GingaShift/hydra-electronics/Elec_Hydra/Main_Board/HYDRA_MAIN_BOARD_V1_A1/HYDRA_MAIN_V1/fabrication/DRILL_REPORT.txt

Drill report for HYDRA_MAIN_V1.kicad_pcb
Created on 2026-10-28T00:51:30+0100

Copper Layer Stackup:
    =============================================================
    L1 :  F.Cu                      front
    L2 :  In1.Cu                    in1
    L3 :  In2.Cu                    in2
    L4 :  B.Cu                      back

Drill file 'HYDRA_MAIN_V1-PTH.drl' contains
    plated through holes:
    =============================================================
    T1  0.300mm  0.0118"  (118 holes)
    T2  0.600mm  0.0236"  (4 holes)  (with 4 slots)
    T3  0.800mm  0.0315"  (17 holes)
    T4  1.000mm  0.0394"  (10 holes)

    Total plated holes count 149

Drill file 'HYDRA_MAIN_V1-NPTH.drl' contains
    unplated through holes:
    =============================================================
    T1  0.650mm  0.0256"  (2 holes)
    T2  2.410mm  0.0949"  (2 holes)
    T3  2.700mm  0.1063"  (4 holes)

    Total unplated holes count 8
