GingaShift/hydra-electronics/Elec_Hydra/Main_Board/HYDRA_MAIN_BOARD_V1_A1/HYDRA_MAIN_V1/docs/OPTIMISATION_A1.md

# Révision A1 — placement compact

|Critère|A0|A1|
|---|---:|---:|
|Largeur|90mm|75mm|
|Hauteur|75mm|60mm|
|Surface|6750mm²|4500mm²|
|Écart de surface|—|−33,3%|

Les87éléments du modèle, les références fabricant, les empreintes et les affectations électriques ont été comparés : aucune modification électrique. Le placement, les pistes, les vias, les contours et les points de fixation sont reconstruits. Le logo vectoriel de40mm est conservé pour respecter ses détails imprimables.

Les composants restent sur la face supérieure. Les plans internes restent dédiés àGND et3V3. Le couloir USB est raccourci par le rapprochement du bord droit et du connecteur. Les dégagements mécaniques et électriques ne sont pas réduits pour masquer un chevauchement.

Les espaces restants servent au branchement, aux fixations, au débogage, à la dissipation et à la sérigraphie; ils ne constituent pas une preuve d’un minimum mathématique de surface. Le contour reste provisoire en attente des contraintes du caisson.

Longueur totale des pistes mesurée dans les fichiers natifs : A0≈1675,5mm, A1≈1516,7mm, soit environ9,5%de moins (somme des segments, hors longueurs verticales des vias).
