GingaShift/hydra-electronics/Elec_Hydra/Main_Board/HYDRA_MAIN_BOARD_V1_A1/HYDRA_MAIN_V1/docs/BOM_DETAIL.csv

Designator | Value | Manufacturer | MPN | Footprint | Notes
U1 | STM32F405RGT6 | STMicroelectronics | STM32F405RGT6 | HYDRA:LQFP-64_10x10mm_P0.5mm
C1 | 100n | Murata | GRM188R71C104KA01D | HYDRA:C_0603_1608Metric
C2 | 100n | Murata | GRM188R71C104KA01D | HYDRA:C_0603_1608Metric
C3 | 100n | Murata | GRM188R71C104KA01D | HYDRA:C_0603_1608Metric
C4 | 100n | Murata | GRM188R71C104KA01D | HYDRA:C_0603_1608Metric
C5 | 4.7u | Murata | GRM21BR71A475KA73L | HYDRA:C_0805_2012Metric
C6 | 2.2u | Murata | GRM188R71A225KE15D | HYDRA:C_0603_1608Metric
C7 | 2.2u | Murata | GRM188R71A225KE15D | HYDRA:C_0603_1608Metric
FB1 | 600R@100MHz | Murata | BLM18AG601SN1D | HYDRA:L_0603_1608Metric
C8 | 100n | Murata | GRM188R71C104KA01D | HYDRA:C_0603_1608Metric
C9 | 4.7u | Murata | GRM21BR71A475KA73L | HYDRA:C_0805_2012Metric
Y1 | 8MHz CL10pF | ECS | ECS-80-10-33-CHN-TR | HYDRA:Crystal_SMD_3225-4Pin_3.2x2.5mm | CL10pF; C0max5pF ESRmax400R; gmcrit0.91mA/V, qualifier oscillation
C10 | 14p | Murata | GRM1885C1H140JA01D | HYDRA:C_0603_1608Metric
C11 | 14p | Murata | GRM1885C1H140JA01D | HYDRA:C_0603_1608Metric
R1 | 10k | Yageo | RC0603FR-0710KL | HYDRA:R_0603_1608Metric
R2 | 10k | Yageo | RC0603FR-0710KL | HYDRA:R_0603_1608Metric
R3 | 10k | Yageo | RC0603FR-0710KL | HYDRA:R_0603_1608Metric
C12 | 100n | Murata | GRM188R71C104KA01D | HYDRA:C_0603_1608Metric
SW1 | BOOT | E-Switch | TL3342F160QG | HYDRA:SW_SPST_TL3342
SW2 | RESET | E-Switch | TL3342F160QG | HYDRA:SW_SPST_TL3342
J1 | 5V POWER IN | Molex | 43650-0221 | HYDRA:Molex_Micro-Fit_3.0_43650-0221_1x02_P3.00mm_Vertical
F1 | 0.50A hold | Littelfuse | 1206L050/15YR | HYDRA:Fuse_1206_3216Metric
F2 | 0.50A hold | Littelfuse | 1206L050/15YR | HYDRA:Fuse_1206_3216Metric
D1 | SS14 | Vishay | SS14-E3/61T | HYDRA:D_SMA | OR passif; protege retours et inversion polarite
D2 | SS14 | Vishay | SS14-E3/61T | HYDRA:D_SMA | OR passif; protege retours et inversion polarite
U2 | AP7361C-33E-13 | Diodes Inc. | AP7361C-33E-13 | HYDRA:SOT-223-3_TabPin2 | SOT223: 1IN 2GND/tab 3OUT, pas AMS1117
C13 | 4.7u | Murata | GRM21BR71A475KA73L | HYDRA:C_0805_2012Metric
C14 | 4.7u | Murata | GRM21BR71A475KA73L | HYDRA:C_0805_2012Metric
C15 | 100n | Murata | GRM188R71C104KA01D | HYDRA:C_0603_1608Metric
J5 | USB-C USB2 DEVICE | GCT | USB4105-GF-A | HYDRA:USB_C_Receptacle_GCT_USB4105-xx-A_16P_TopMnt_Horizontal
R4 | 5.1k | Yageo | RC0603FR-075K1L | HYDRA:R_0603_1608Metric
R5 | 5.1k | Yageo | RC0603FR-075K1L | HYDRA:R_0603_1608Metric
U5 | USBLC6-2SC6 | STMicroelectronics | USBLC6-2SC6 | HYDRA:SOT-23-6
C16 | 100n | Murata | GRM188R71C104KA01D | HYDRA:C_0603_1608Metric
R6 | 22 | Yageo | RC0603FR-0722RL | HYDRA:R_0603_1608Metric
R7 | 22 | Yageo | RC0603FR-0722RL | HYDRA:R_0603_1608Metric
R8 | 33k | Yageo | RC0603FR-0733KL | HYDRA:R_0603_1608Metric
R9 | 82k | Yageo | RC0603FR-0782KL | HYDRA:R_0603_1608Metric
R10 | 3.3k | Yageo | RC0603FR-073K3L | HYDRA:R_0603_1608Metric
D3 | PWR_5V | Lite-On | LTST-C190KGKT | HYDRA:LED_0603_1608Metric | green
R11 | 2.2k | Yageo | RC0603FR-072K2L | HYDRA:R_0603_1608Metric
D4 | PWR_3V3 | Lite-On | LTST-C190KGKT | HYDRA:LED_0603_1608Metric | green
R12 | 1k | Yageo | RC0603FR-071KL | HYDRA:R_0603_1608Metric
D5 | STATUS | Lite-On | LTST-C190TBKT | HYDRA:LED_0603_1608Metric | blue
R13 | 2.2k | Yageo | RC0603FR-072K2L | HYDRA:R_0603_1608Metric
D6 | DATA | Lite-On | LTST-C190KSKT | HYDRA:LED_0603_1608Metric | yellow
U3 | W25Q128JVSIQ | Winbond | W25Q128JVSIQ | HYDRA:SOIC-8_5.23x5.23mm_P1.27mm
C17 | 100n | Murata | GRM188R71C104KA01D | HYDRA:C_0603_1608Metric
C18 | 4.7u | Murata | GRM21BR71A475KA73L | HYDRA:C_0805_2012Metric
R14 | 10k | Yageo | RC0603FR-0710KL | HYDRA:R_0603_1608Metric
R15 | 10k | Yageo | RC0603FR-0710KL | HYDRA:R_0603_1608Metric
R16 | 10k | Yageo | RC0603FR-0710KL | HYDRA:R_0603_1608Metric
U4 | BME280 | Bosch Sensortec | BME280 | HYDRA:Bosch_LGA-8_2.5x2.5mm_P0.65mm_ClockwisePinNumbering | I2C3 adresse7bits0x77, CSB1 SDO1
C19 | 100n | Murata | GRM188R71C104KA01D | HYDRA:C_0603_1608Metric
C20 | 100n | Murata | GRM188R71C104KA01D | HYDRA:C_0603_1608Metric
R17 | 4.7k | Yageo | RC0603FR-074K7L | HYDRA:R_0603_1608Metric
R18 | 4.7k | Yageo | RC0603FR-074K7L | HYDRA:R_0603_1608Metric
R19 | 10k | Yageo | RC0603FR-0710KL | HYDRA:R_0603_1608Metric
J2 | POWER I2C ALERT | Molex | 53253-0470 | HYDRA:Molex_Micro-Latch_53253-0470_1x04_P2.00mm_Vertical
R20 | 47 | Yageo | RC0603FR-0747RL | HYDRA:R_0603_1608Metric
R21 | 47 | Yageo | RC0603FR-0747RL | HYDRA:R_0603_1608Metric
R22 | 1k | Yageo | RC0603FR-071KL | HYDRA:R_0603_1608Metric
R23 | 2.2k | Yageo | RC0603FR-072K2L | HYDRA:R_0603_1608Metric
R24 | 2.2k | Yageo | RC0603FR-072K2L | HYDRA:R_0603_1608Metric
R25 | 10k | Yageo | RC0603FR-0710KL | HYDRA:R_0603_1608Metric
J3 | RPi UART 3V3 | Molex | 53253-0370 | HYDRA:Molex_Micro-Latch_53253-0370_1x03_P2.00mm_Vertical | vers Navigator SERIAL3: 1 vers RX3, 2 vers TX2, 3 vers GND6
R26 | 1k | Yageo | RC0603FR-071KL | HYDRA:R_0603_1608Metric
R27 | 1k | Yageo | RC0603FR-071KL | HYDRA:R_0603_1608Metric
J4 | 8 GPIO V2 LOGIC | Molex | 53253-1070 | HYDRA:Molex_Micro-Latch_53253-1070_1x10_P2.00mm_Vertical | 3V3 logique max50mA; aucune puissance actionneur
J6 | SWD 2.54mm | Wurth | 61301021121 | HYDRA:PinHeader_2x05_P2.54mm_Vertical | Standard ARM signaux mais pas pas1.27: adaptateur requis
TP1 | +5V_SYS |  |  | HYDRA:TestPoint_Pad_D1.5mm | Test pad
TP2 | +3V3 |  |  | HYDRA:TestPoint_Pad_D1.5mm | Test pad
TP3 | GND |  |  | HYDRA:TestPoint_Pad_D1.5mm | Test pad
TP4 | NRST |  |  | HYDRA:TestPoint_Pad_D1.5mm | Test pad
TP5 | UART_TX |  |  | HYDRA:TestPoint_Pad_D1.5mm | Test pad
TP6 | UART_RX |  |  | HYDRA:TestPoint_Pad_D1.5mm | Test pad
TP7 | PB_SDA |  |  | HYDRA:TestPoint_Pad_D1.5mm | Test pad
TP8 | PB_SCL |  |  | HYDRA:TestPoint_Pad_D1.5mm | Test pad
TP9 | INA_ALERT |  |  | HYDRA:TestPoint_Pad_D1.5mm | Test pad
TP10 | BOOT0 |  |  | HYDRA:TestPoint_Pad_D1.5mm | Test pad
H1 | M2.5 NPTH |  |  | HYDRA:MountingHole_2.7mm_M2.5
H2 | M2.5 NPTH |  |  | HYDRA:MountingHole_2.7mm_M2.5
H3 | M2.5 NPTH |  |  | HYDRA:MountingHole_2.7mm_M2.5
H4 | M2.5 NPTH |  |  | HYDRA:MountingHole_2.7mm_M2.5
