GingaShift/hydra-electronics/Elec_Hydra/Main_Board/HYDRA_MAIN_BOARD_V1_A1/HYDRA_MAIN_V1/Importations 3D/ECS-80-10-33-CHN-TR.stp

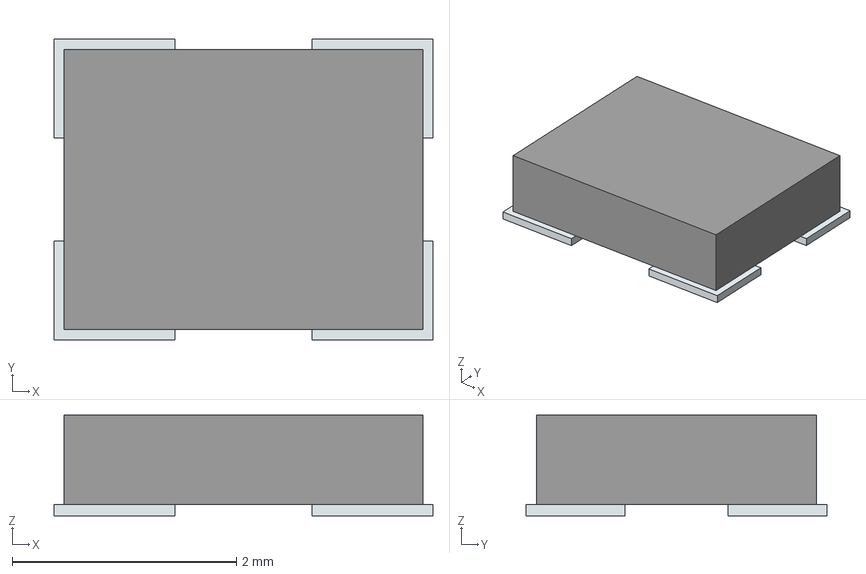
[picture p10: CAD file, 2026-11-01]
Elec_Hydra/Main_Board/HYDRA_MAIN_BOARD_V1_A1/HYDRA_MAIN_V1/Importations 3D/ECS-80-10-33-CHN-TR.stp
3.38 x 2.68 x 0.9 mm
Pins
