GingaShift/hydra-electronics/Elec_Hydra/Main_Board/HYDRA_MAIN_BOARD_V1_A1/HYDRA_MAIN_V1/Importations 3D/TL3342F160QG.stp

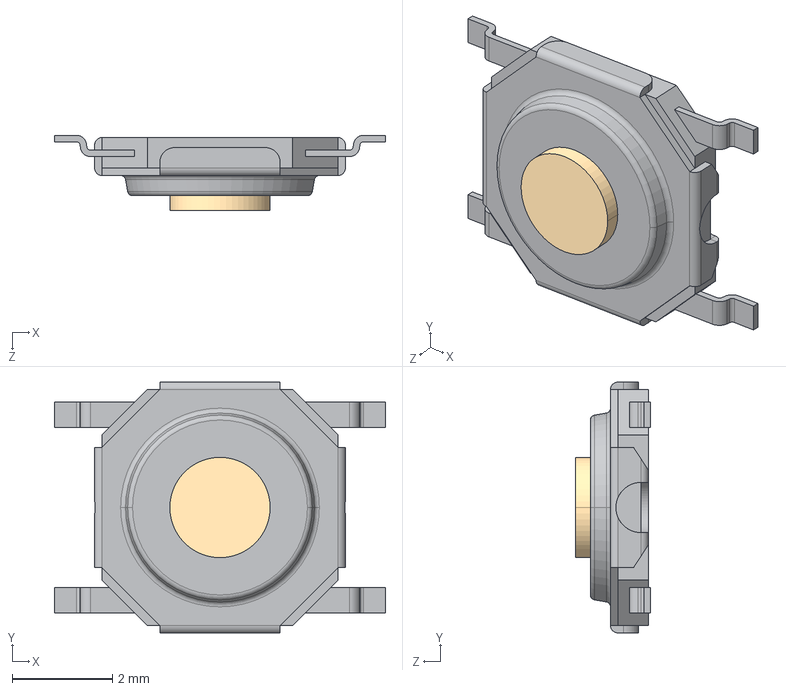
[picture p11: CAD file, 2026-11-01]
Elec_Hydra/Main_Board/HYDRA_MAIN_BOARD_V1_A1/HYDRA_MAIN_V1/Importations 3D/TL3342F160QG.stp
6.60 x 5.00 x 1.50 mm
