GingaShift/hydra-electronics/Elec_Hydra/Main_Board/HYDRA_MAIN_BOARD_V1_A1/HYDRA_MAIN_V1/Importations 3D/0532530370.stp

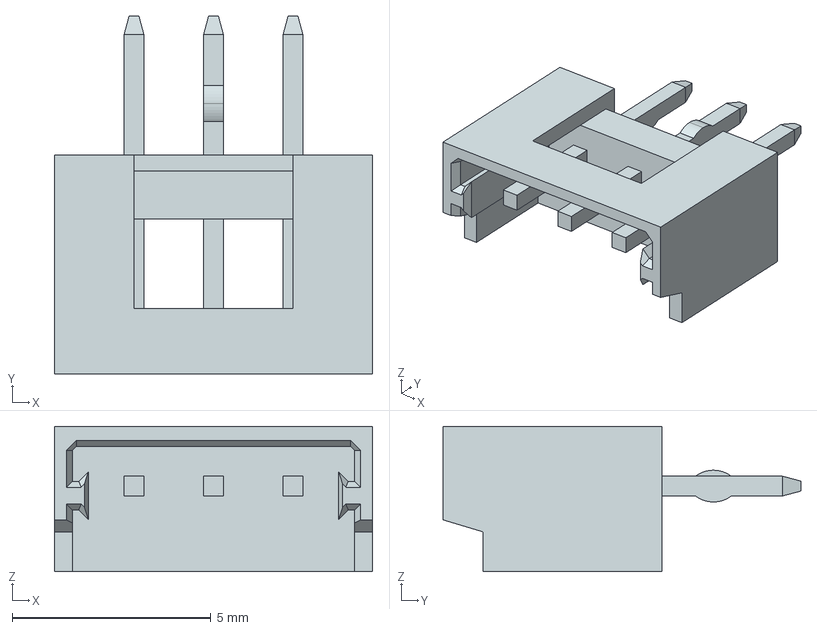
[picture p12: CAD file, 2026-11-01]
Elec_Hydra/Main_Board/HYDRA_MAIN_BOARD_V1_A1/HYDRA_MAIN_V1/Importations 3D/0532530370.stp
8.00 x 9.00 x 3.65 mm
