GingaShift/hydra-electronics/Elec_Hydra/Main_Board/HYDRA_MAIN_BOARD_V1_A1/HYDRA_MAIN_V1/Importations 3D/1206L050_15YR.stp

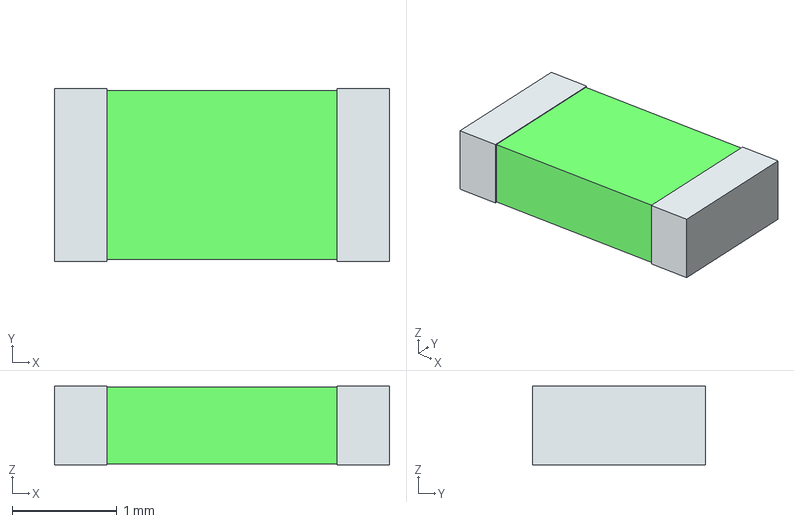
[picture p13: CAD file, 2026-11-01]
Elec_Hydra/Main_Board/HYDRA_MAIN_BOARD_V1_A1/HYDRA_MAIN_V1/Importations 3D/1206L050_15YR.stp
3.20 x 1.65 x 0.75 mm
term1
term2
