GingaShift/hydra-electronics/Elec_Hydra/Main_Board/HYDRA_MAIN_BOARD_V1_A1/HYDRA_MAIN_V1/Importations 3D/0532530470.stp

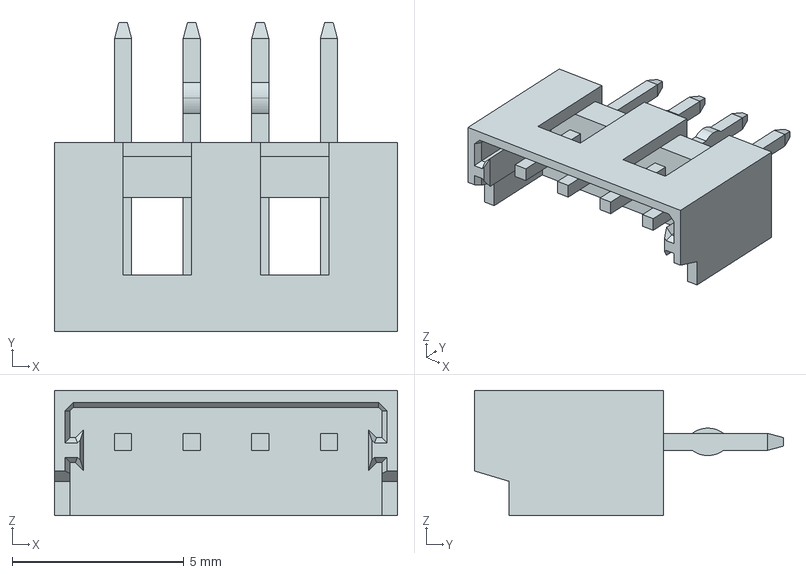
[picture p14: CAD file, 2026-11-01]
Elec_Hydra/Main_Board/HYDRA_MAIN_BOARD_V1_A1/HYDRA_MAIN_V1/Importations 3D/0532530470.stp
10.0 x 9.00 x 3.65 mm
