GingaShift/hydra-electronics/Elec_Hydra/Main_Board/HYDRA_MAIN_BOARD_V1_A1/HYDRA_MAIN_V1/reports/pcb_build.txt

Supply fanouts 83 unplaced []
Board generated 84 footprints 58 nets
U1 19 35.25 35.675
U1 32 41.75 35.675
U1 48 43.675 26.25
U1 64 34.25 24.325
U1 31 41.25 35.675
U1 47 43.675 26.75
U1 44 43.675 28.25
U1 45 43.675 27.75
U1 5 32.325 28.25
U1 6 32.325 28.75
U1 12 32.325 31.75
U1 13 32.325 32.25
