GingaShift/hydra-electronics/Elec_Hydra/Main_Board/HYDRA_MAIN_BOARD_V1_A1/HYDRA_MAIN_V1/reports/VALIDATION.md

# Validation A1 compacte

Contour75×60mm,6750→4500mm² (−33,3%). Les références, empreintes, valeurs et nets des87éléments du modèle ont été comparés àA0 : aucun changement électrique. La sérigraphie, les fixations, le placement et le routage sont reconstruits.

Contrôles natifsKiCad9.0.9 : ERC0, DRC0, connexions non routées0, parité schéma/PCB0. Comparaison indépendante XML schéma/pastilles :0écart. Routage final :675segments,118vias. Deux plans internes remplisGND/In1.Cu et3V3/In2.Cu, aucune piste de signal interne.

La liaison STATUS a été routée avant les autres signaux afin de préserver son accès depuisPC8 dans le placement compact. Les deux LEDs d’alimentation, STATUS/DATA et toutes les extensions sont conservées.

Le logo vectoriel officiel40mm reste inchangé. Le contour mécanique est provisoire. Les réserves de qualification physique, thermique, HSE etUSB, de stackup90Ω, de configurationBlueOS et de stock/assemblage restent celles du dossier technique. Aucun essai matériel n’est revendiqué.

**NO-GO commande automatique** avant validation mécanique et qualification du prototype.
