GingaShift/hydra-electronics/Elec_Hydra/Main_Board/HYDRA_MAIN_BOARD_V1_A1/HYDRA_MAIN_V1/HYDRA_SCHEMA.pdf

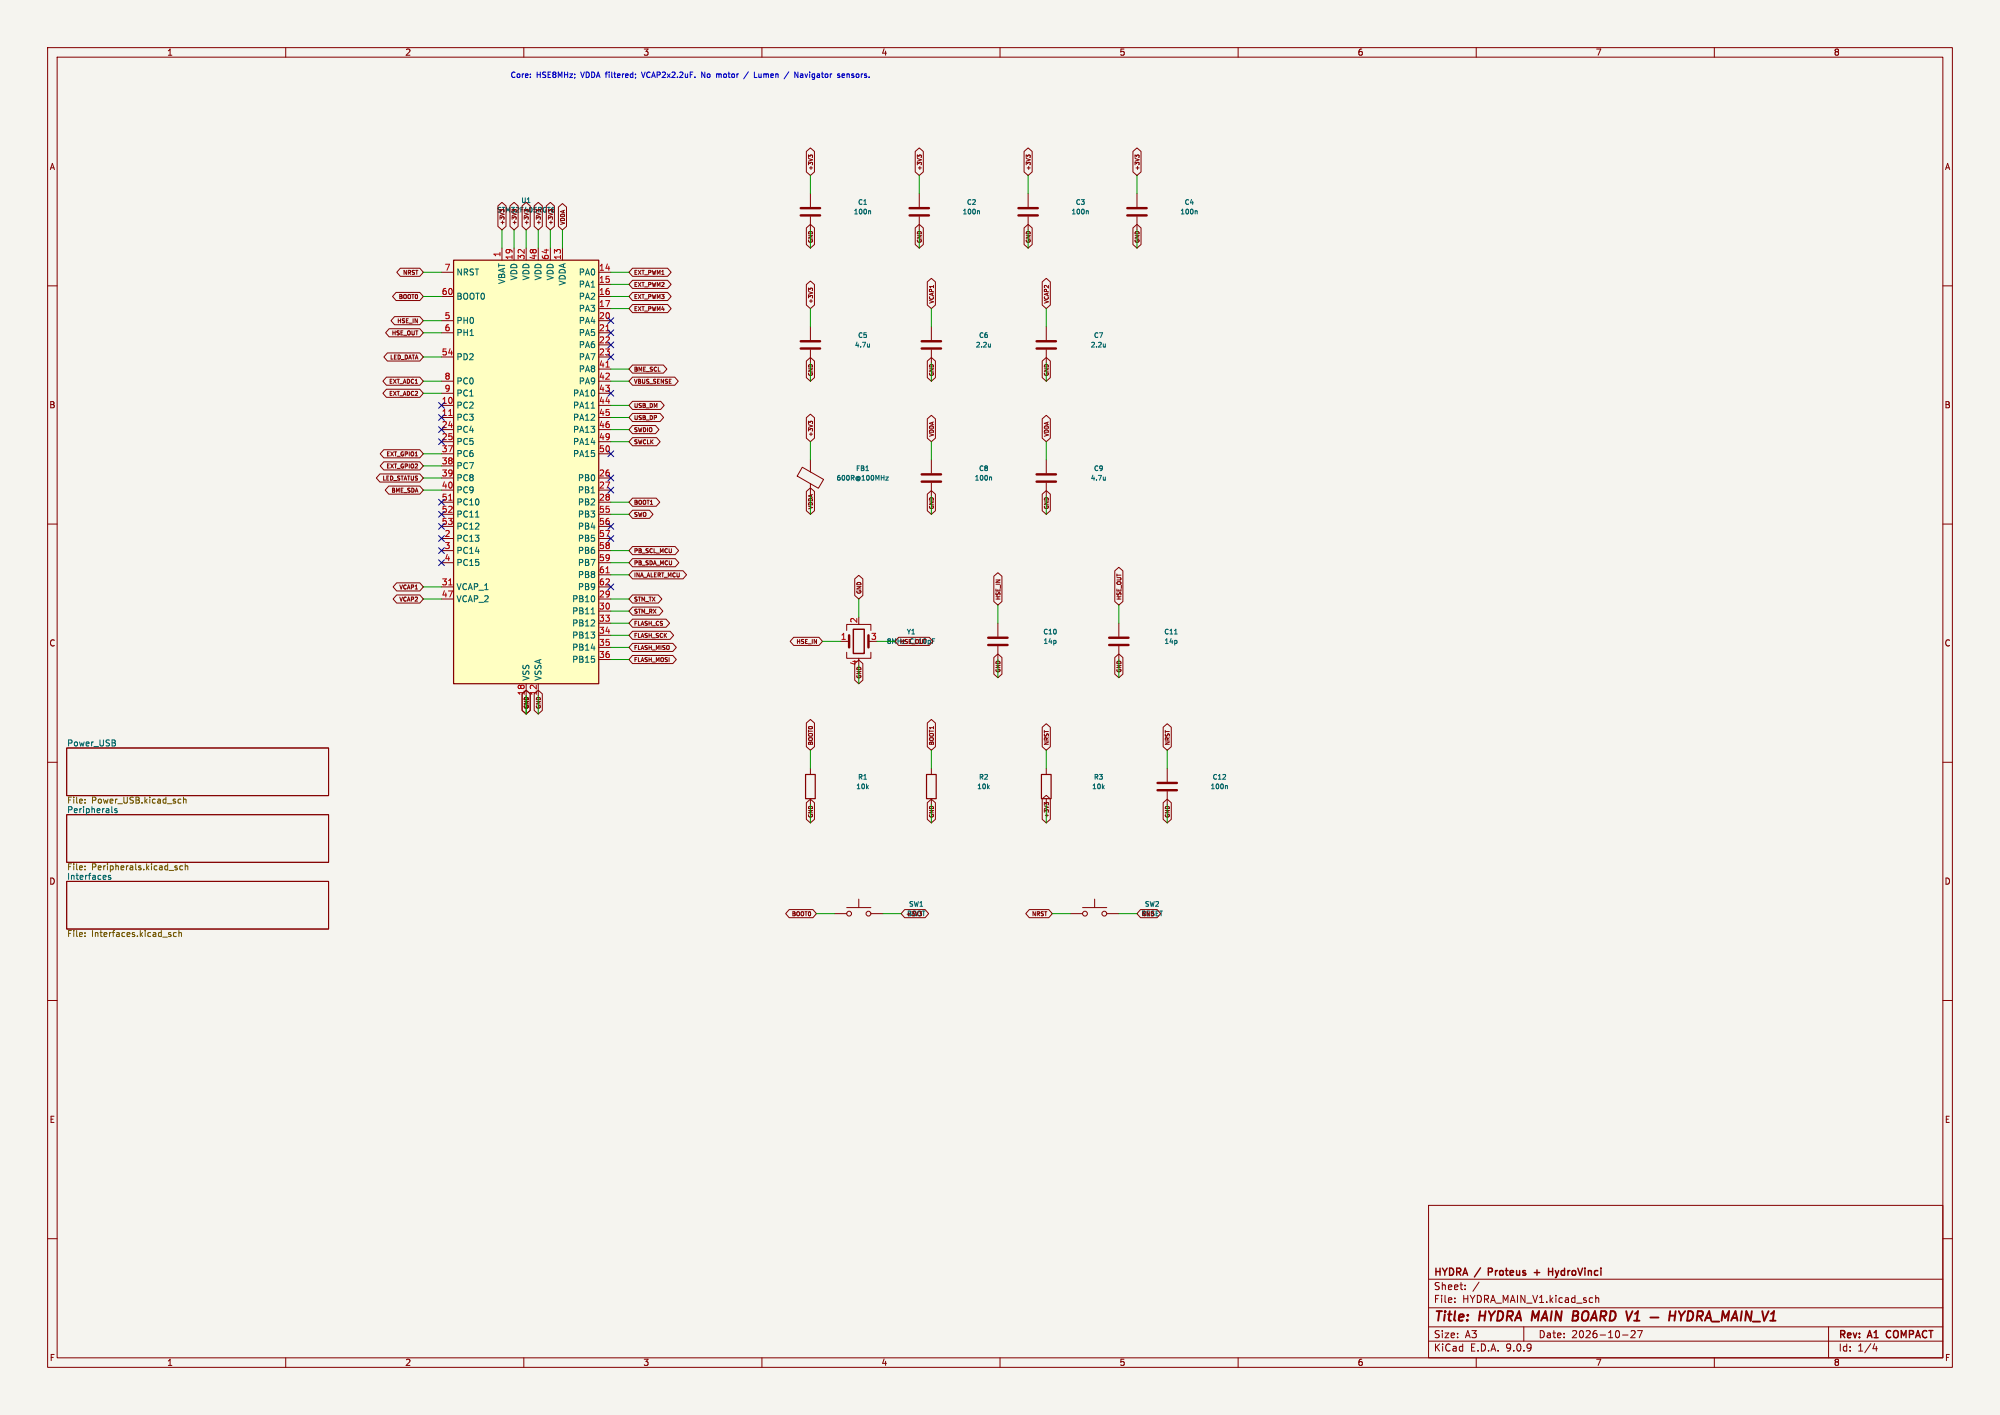
[picture p17: page 1]

1 VDD 19 VDD 32 VSS 18 VDD 48 VSSA 12 VDD 64 VDDA 13 PA0 14 PA1 15 PA2 16 PA3 17 PA4 20 PA5 21 PA6 22 PA7 23 PA8 41 PA9 42 PA10 43 PA11 44 PA12 45 PA13 46 PA14 49 PA15 50 PB0 26 PB1 27 PB2 28 PB3 55 PB4 56 PB5 57 PB6 58 PB7 59 PB8 61 PB9 62 PB10 29 PB11 30 PB12 33 PB13 34 PB14 35 PB15 36

Interfaces File: Interfaces.kicad_sch Peripherals File: Peripherals.kicad_sch Power_USB

Id: 1/4 Title: HYDRA MAIN BOARD V1 þÿ HYDRA_MAIN_V1

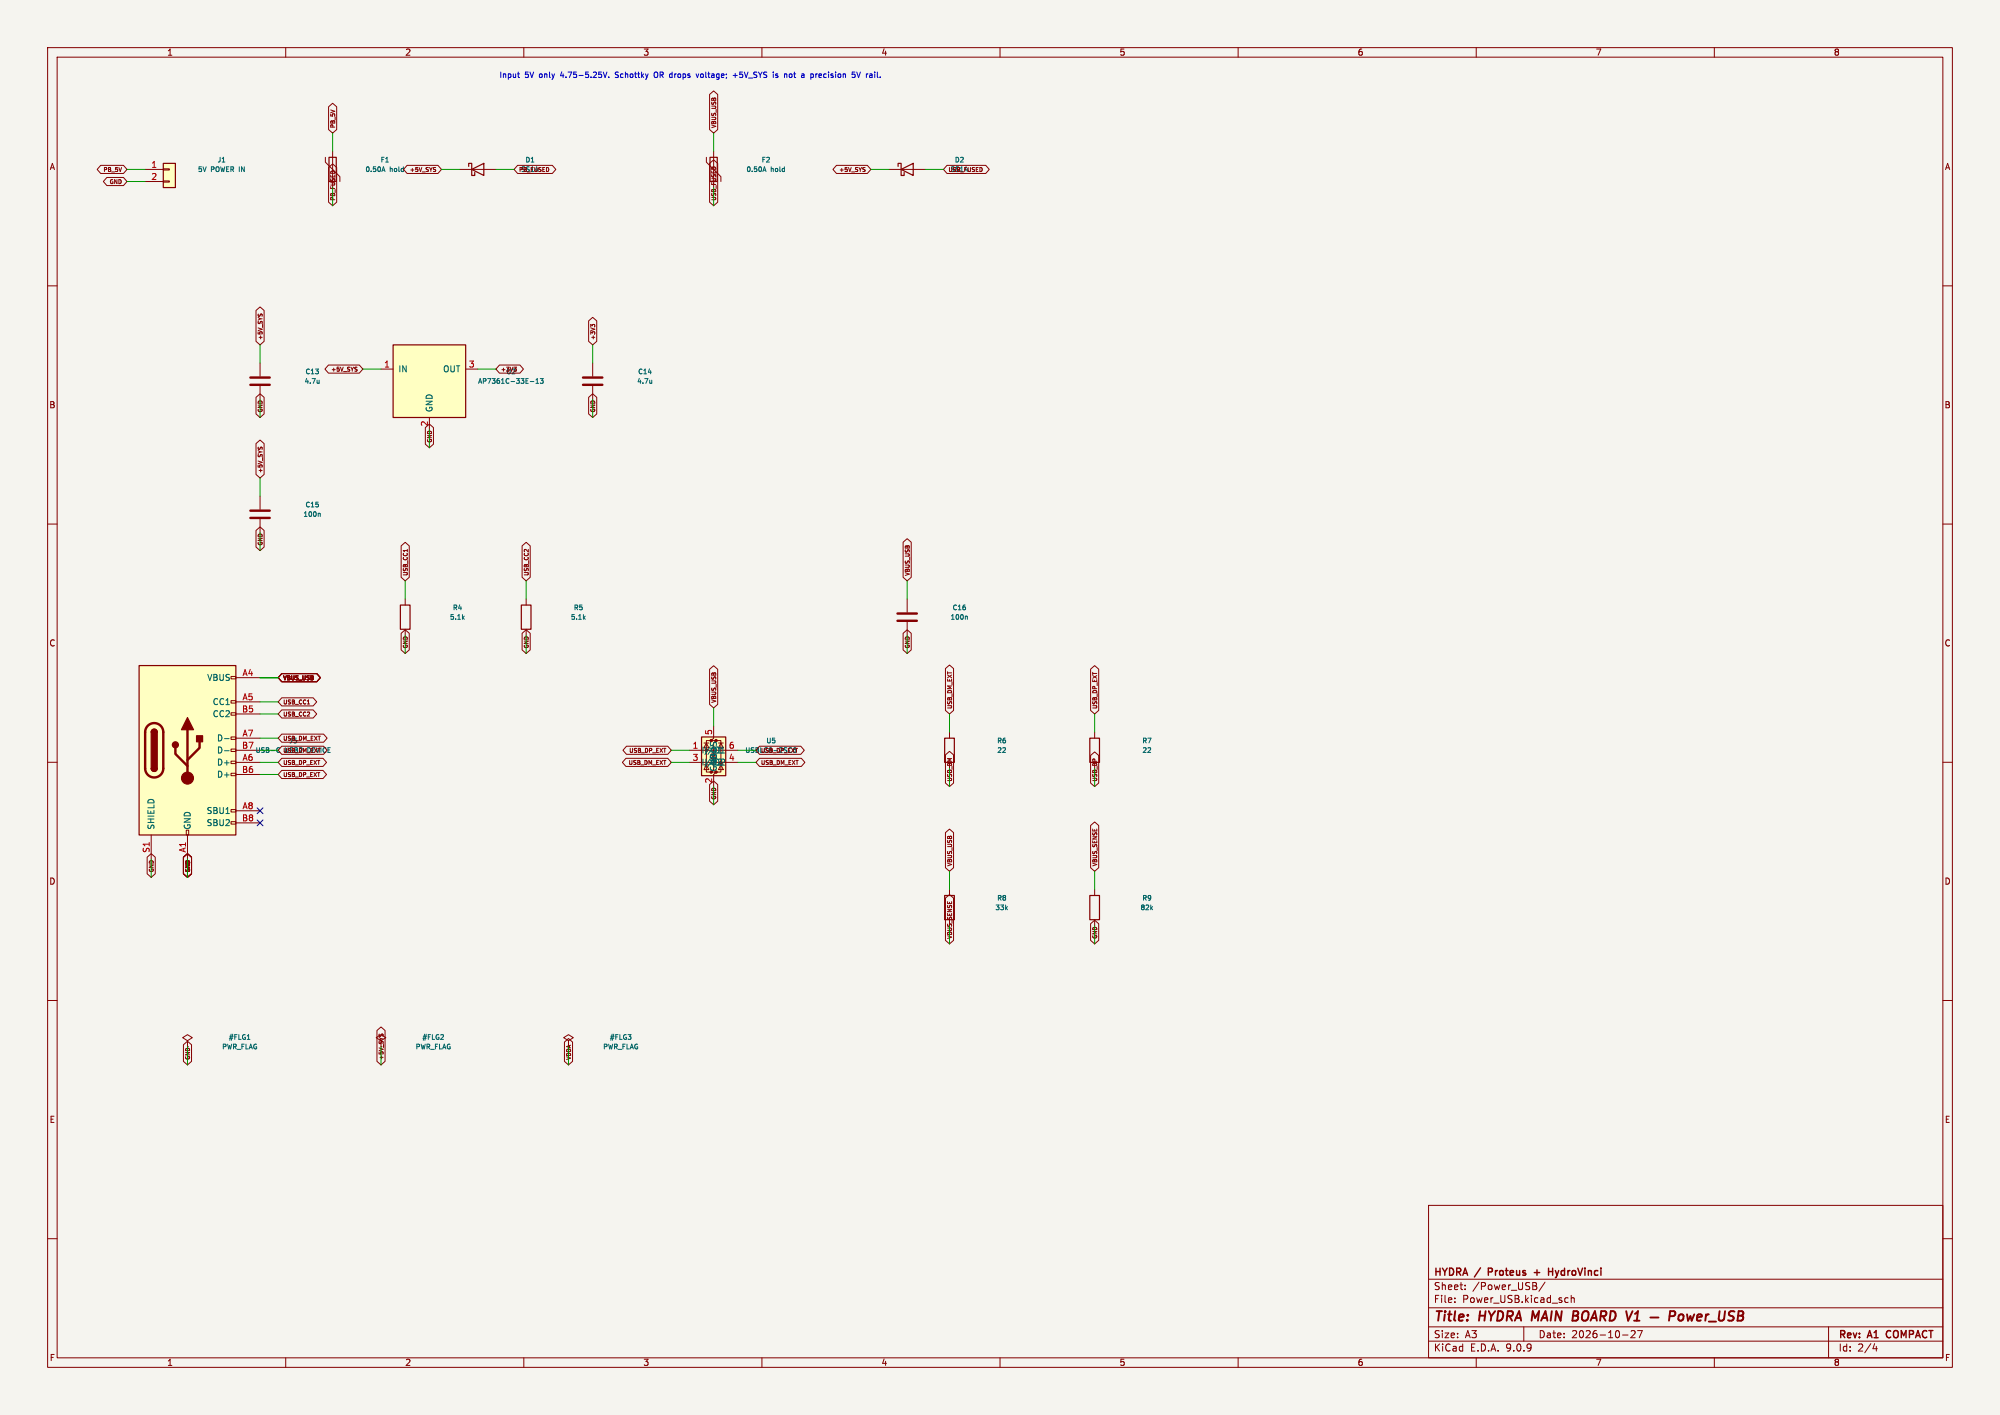
[picture p18: page 2]

Id: 2/4 Title: HYDRA MAIN BOARD V1 þÿ Power_USB

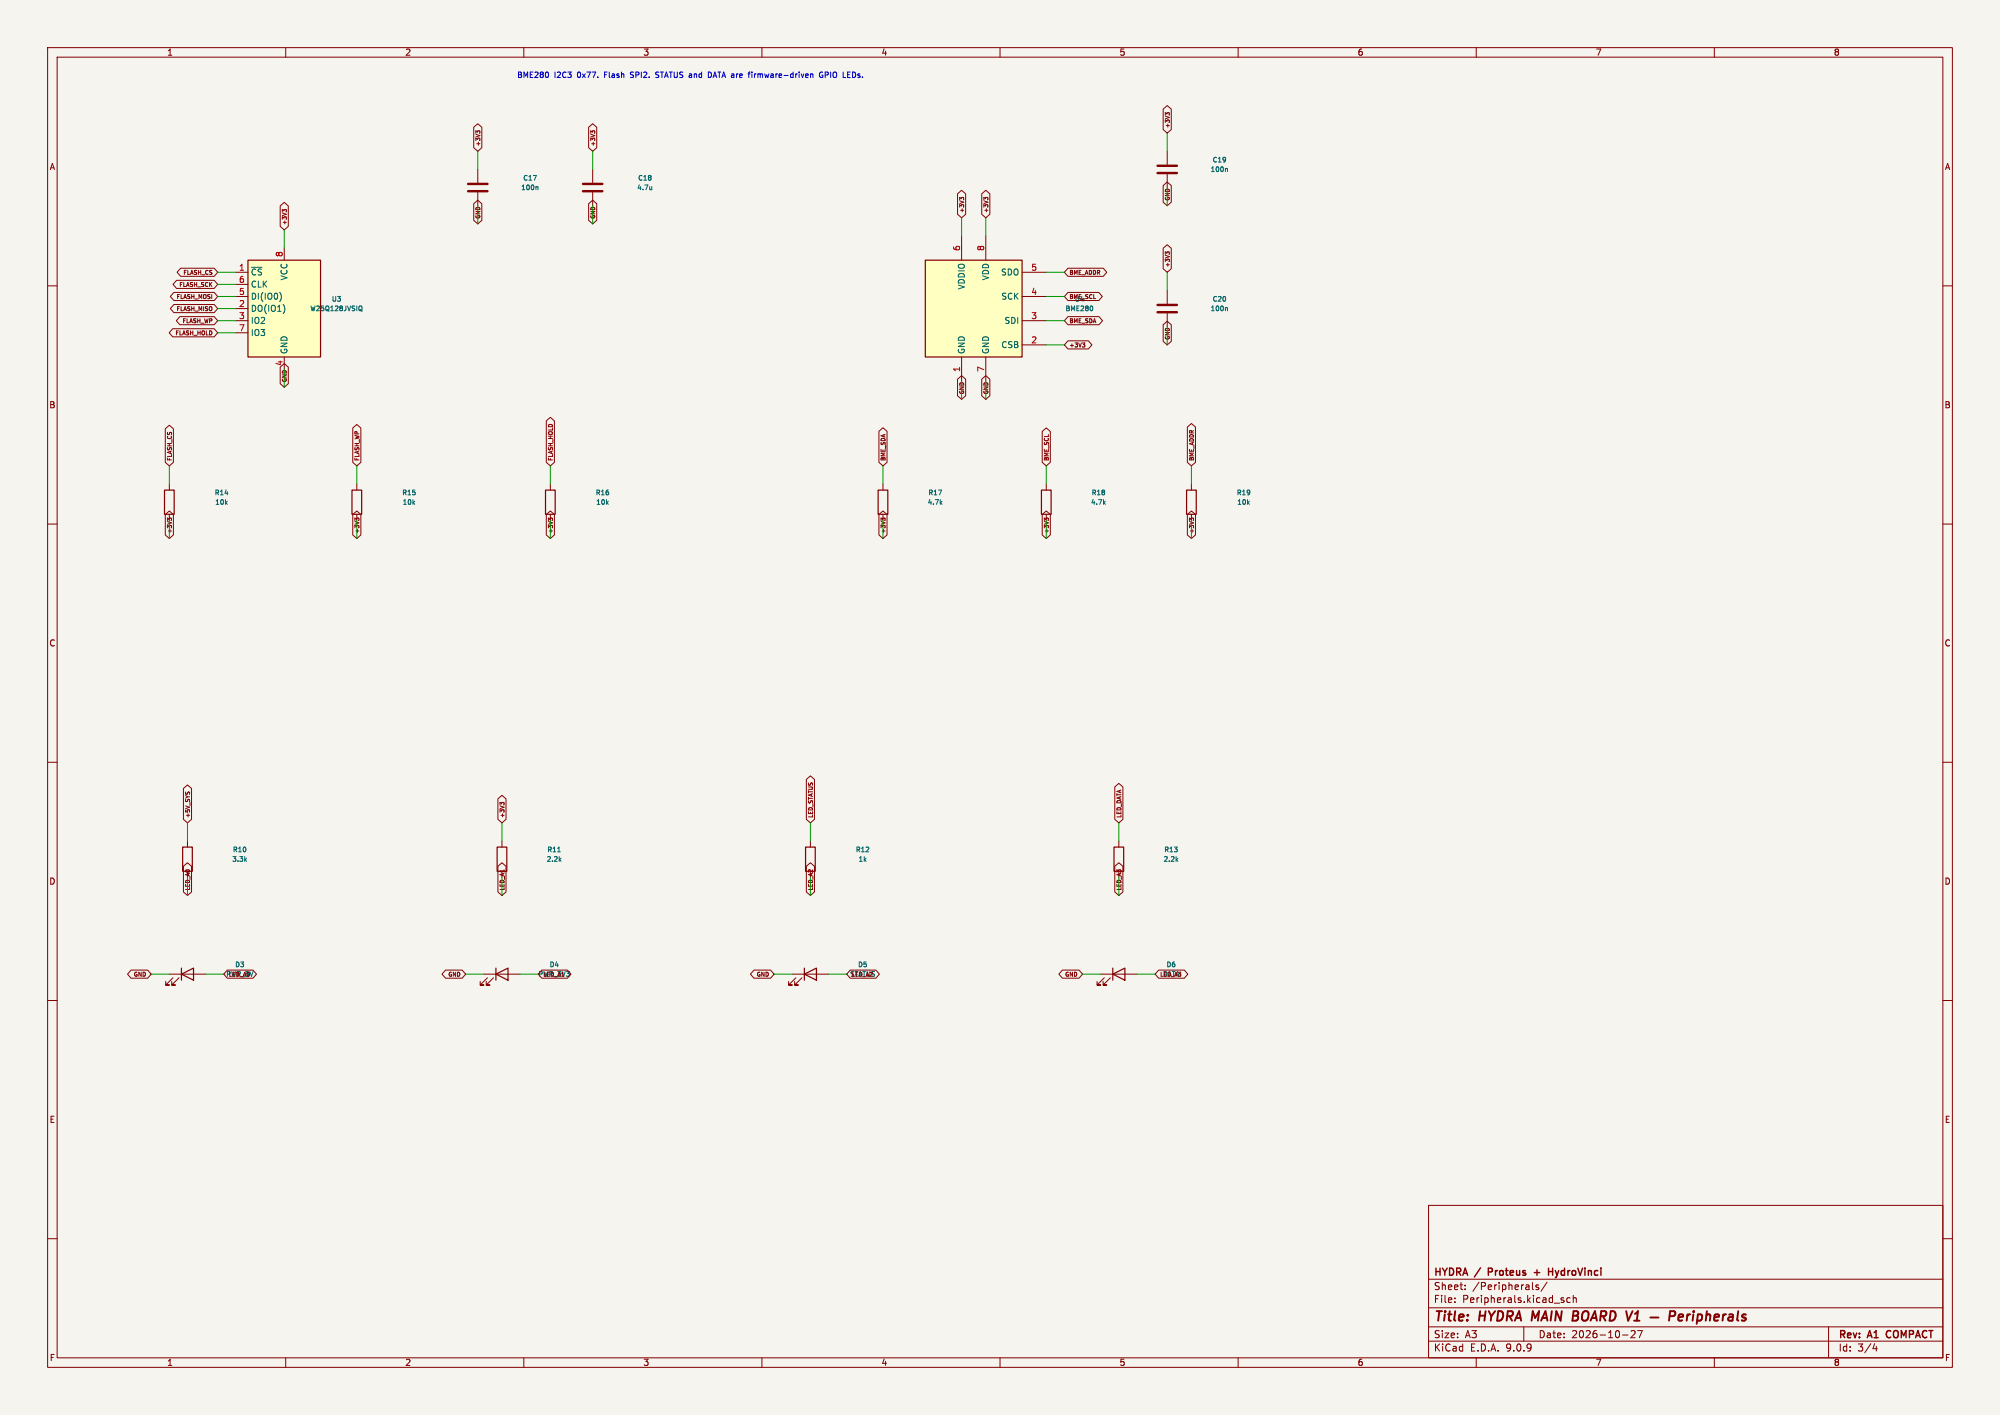
[picture p19: page 3]

7 SDO 5 SCK 4 SDI 3 CSB 2 U4 BME280

Id: 3/4 Title: HYDRA MAIN BOARD V1 þÿ Peripherals

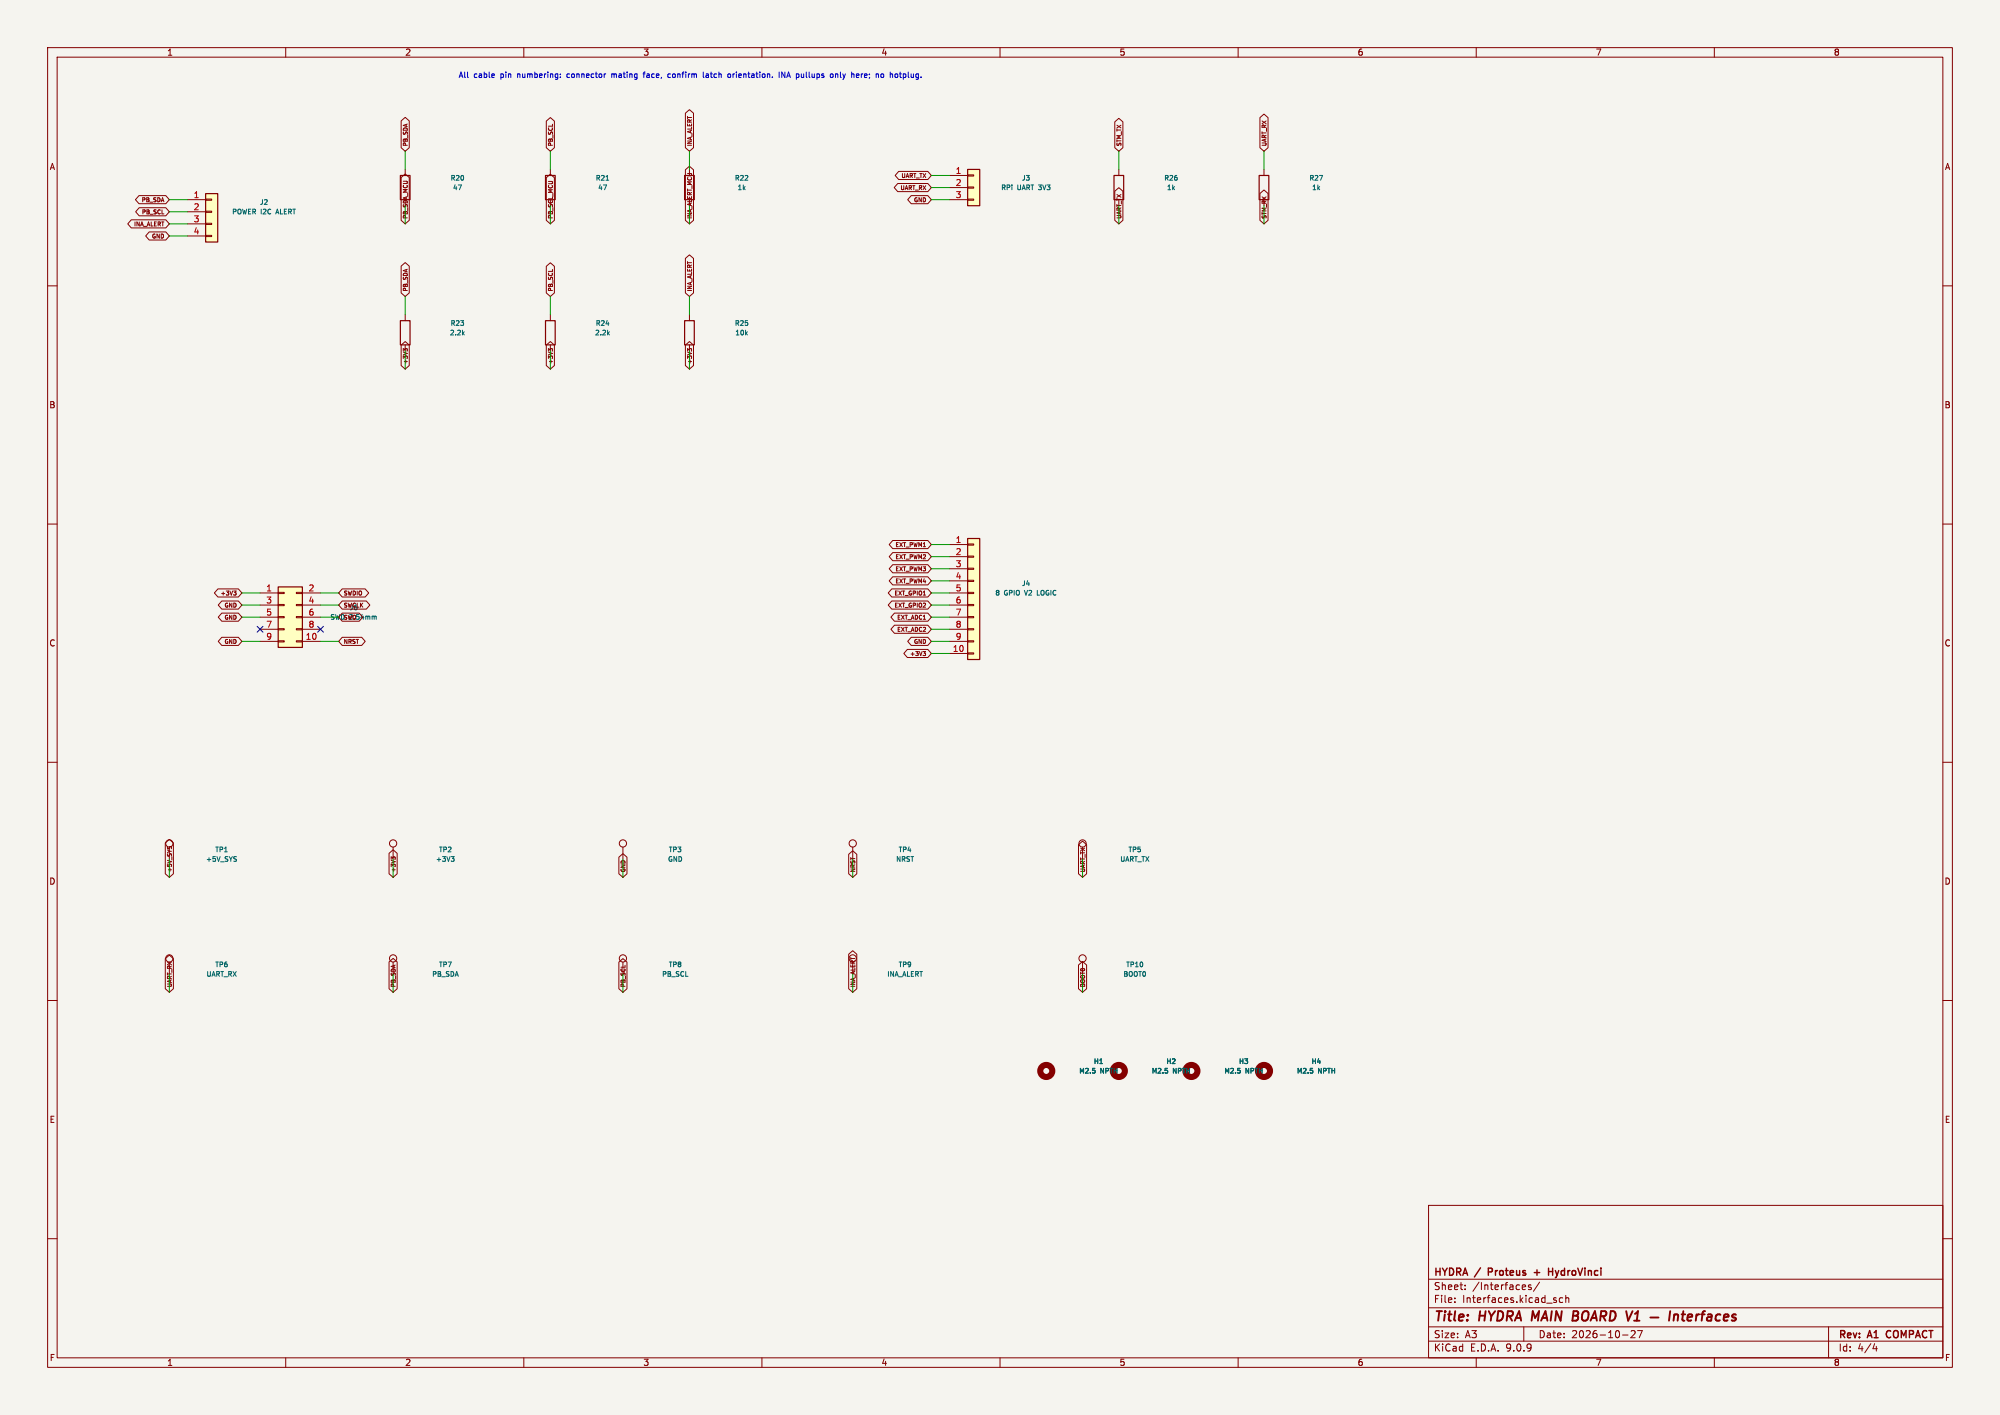
[picture p20: page 4]

Id: 4/4 Title: HYDRA MAIN BOARD V1 þÿ Interfaces
