GingaShift/hydra-electronics/(list of files, drawings)

Other design files:
Elec_Hydra/Main_Board/HYDRA_MAIN_BOARD_V1_A1/HYDRA_MAIN_V1/reports/HYDRA_unrouted.dsn
