GingaShift/hydra-electronics/Elec_Hydra/Main_Board/HYDRA_MAIN_BOARD_V1_A1/HYDRA_MAIN_V1/HYDRA_MAIN_V1.kicad_pcb

## KiCad design Elec_Hydra/Main_Board/HYDRA_MAIN_BOARD_V1_A1/HYDRA_MAIN_V1/HYDRA_MAIN_V1.kicad_pcb (2026-11-01)

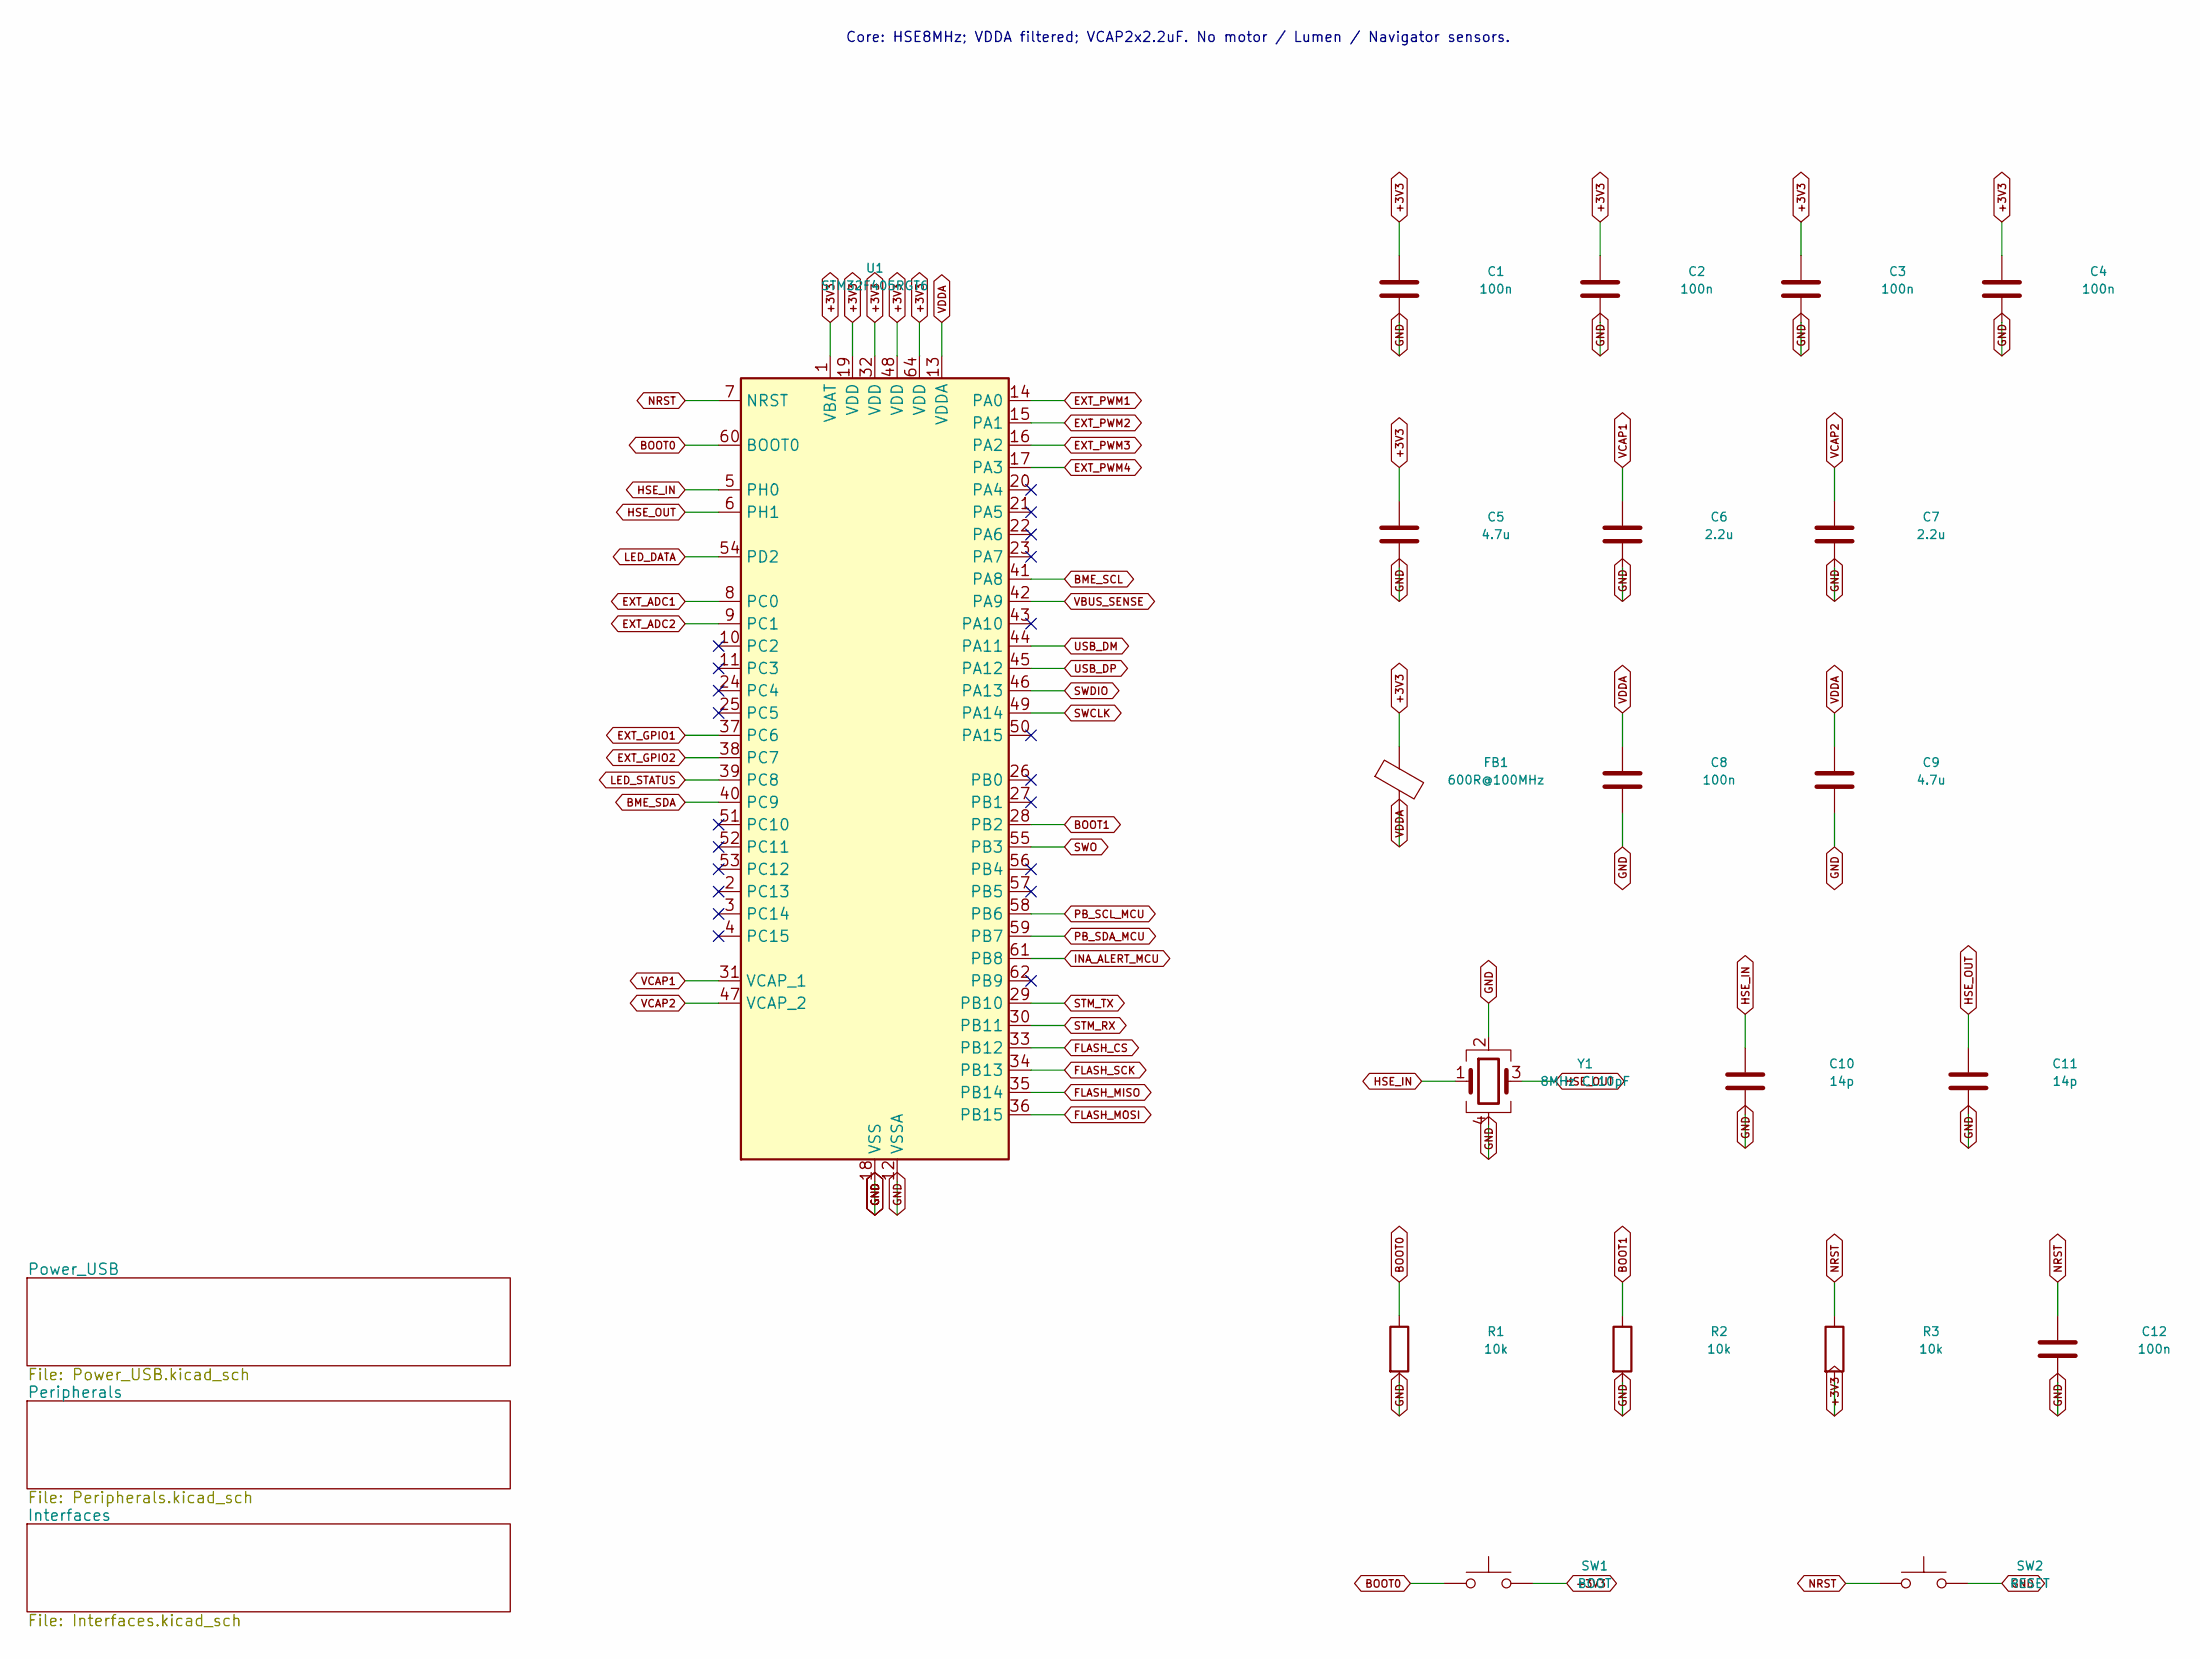
[picture p21: schematic HYDRA_MAIN_V1.kicad_sch, HYDRA MAIN BOARD V1 — HYDRA_MAIN_V1]

Parts:
C1, C2, C3, C4, C8, C12: 100n; C_0603_1608Metric; MPN GRM188R71C104KA01D
C5, C9: 4.7u; C_0805_2012Metric; MPN GRM21BR71A475KA73L
C6, C7: 2.2u; C_0603_1608Metric; MPN GRM188R71A225KE15D
C10, C11: 14p; C_0603_1608Metric; MPN GRM1885C1H140JA01D
FB1: 600R@100MHz; L_0603_1608Metric; MPN BLM18AG601SN1D
R1, R2, R3: 10k; R_0603_1608Metric; MPN RC0603FR-0710KL
SW1: BOOT; SW_SPST_TL3342; MPN TL3342F160QG
SW2: RESET; SW_SPST_TL3342; MPN TL3342F160QG
U1: STM32F405RGT6; LQFP-64_10x10mm_P0.5mm; MPN STM32F405RGT6
Y1: 8MHz CL10pF; Crystal_SMD_3225-4Pin_3.2x2.5mm; MPN ECS-80-10-33-CHN-TR

Connections:
+3V3: C1.1, C2.1, C3.1, C4.1, C5.1, FB1.1, R3.2, SW1.2, U1.1 (VBAT), U1.19 (VDD), U1.32 (VDD), U1.48 (VDD), U1.64 (VDD); also elsewhere on the board
BME_SCL: U1.41 (PA8); also elsewhere on the board
BME_SDA: U1.40 (PC9); also elsewhere on the board
BOOT0: R1.1, SW1.1, U1.60 (BOOT0); also elsewhere on the board
BOOT1: R2.1, U1.28 (PB2)
EXT_ADC1: U1.8 (PC0); also elsewhere on the board
EXT_ADC2: U1.9 (PC1); also elsewhere on the board
EXT_GPIO1: U1.37 (PC6); also elsewhere on the board
EXT_GPIO2: U1.38 (PC7); also elsewhere on the board
EXT_PWM1: U1.14 (PA0); also elsewhere on the board
EXT_PWM2: U1.15 (PA1); also elsewhere on the board
EXT_PWM3: U1.16 (PA2); also elsewhere on the board
EXT_PWM4: U1.17 (PA3); also elsewhere on the board
FLASH_CS: U1.33 (PB12); also elsewhere on the board
FLASH_MISO: U1.35 (PB14); also elsewhere on the board
FLASH_MOSI: U1.36 (PB15); also elsewhere on the board
FLASH_SCK: U1.34 (PB13); also elsewhere on the board
GND: C1.2, C2.2, C3.2, C4.2, C5.2, C6.2, C7.2, C8.2, C9.2, C10.2, C11.2, C12.2, R1.2, R2.2, SW2.2, U1.12 (VSSA), U1.18 (VSS), U1.63 (VSS), Y1.2, Y1.4; also elsewhere on the board
HSE_IN: C10.1, U1.5 (PH0), Y1.1
HSE_OUT: C11.1, U1.6 (PH1), Y1.3
INA_ALERT_MCU: U1.61 (PB8); also elsewhere on the board
LED_DATA: U1.54 (PD2); also elsewhere on the board
LED_STATUS: U1.39 (PC8); also elsewhere on the board
NRST: C12.1, R3.1, SW2.1, U1.7 (NRST); also elsewhere on the board
PB_SCL_MCU: U1.58 (PB6); also elsewhere on the board
PB_SDA_MCU: U1.59 (PB7); also elsewhere on the board
STM_RX: U1.30 (PB11); also elsewhere on the board
STM_TX: U1.29 (PB10); also elsewhere on the board
SWCLK: U1.49 (PA14); also elsewhere on the board
SWDIO: U1.46 (PA13); also elsewhere on the board
SWO: U1.55 (PB3); also elsewhere on the board
USB_DM: U1.44 (PA11); also elsewhere on the board
USB_DP: U1.45 (PA12); also elsewhere on the board
VBUS_SENSE: U1.42 (PA9); also elsewhere on the board
VCAP1: C6.1, U1.31 (VCAP_1)
VCAP2: C7.1, U1.47 (VCAP_2)
VDDA: C8.1, C9.1, FB1.2, U1.13 (VDDA)

Notes on the sheet:
Core: HSE8MHz; VDDA filtered; VCAP2x2.2uF. No motor / Lumen / Navigator sensors.

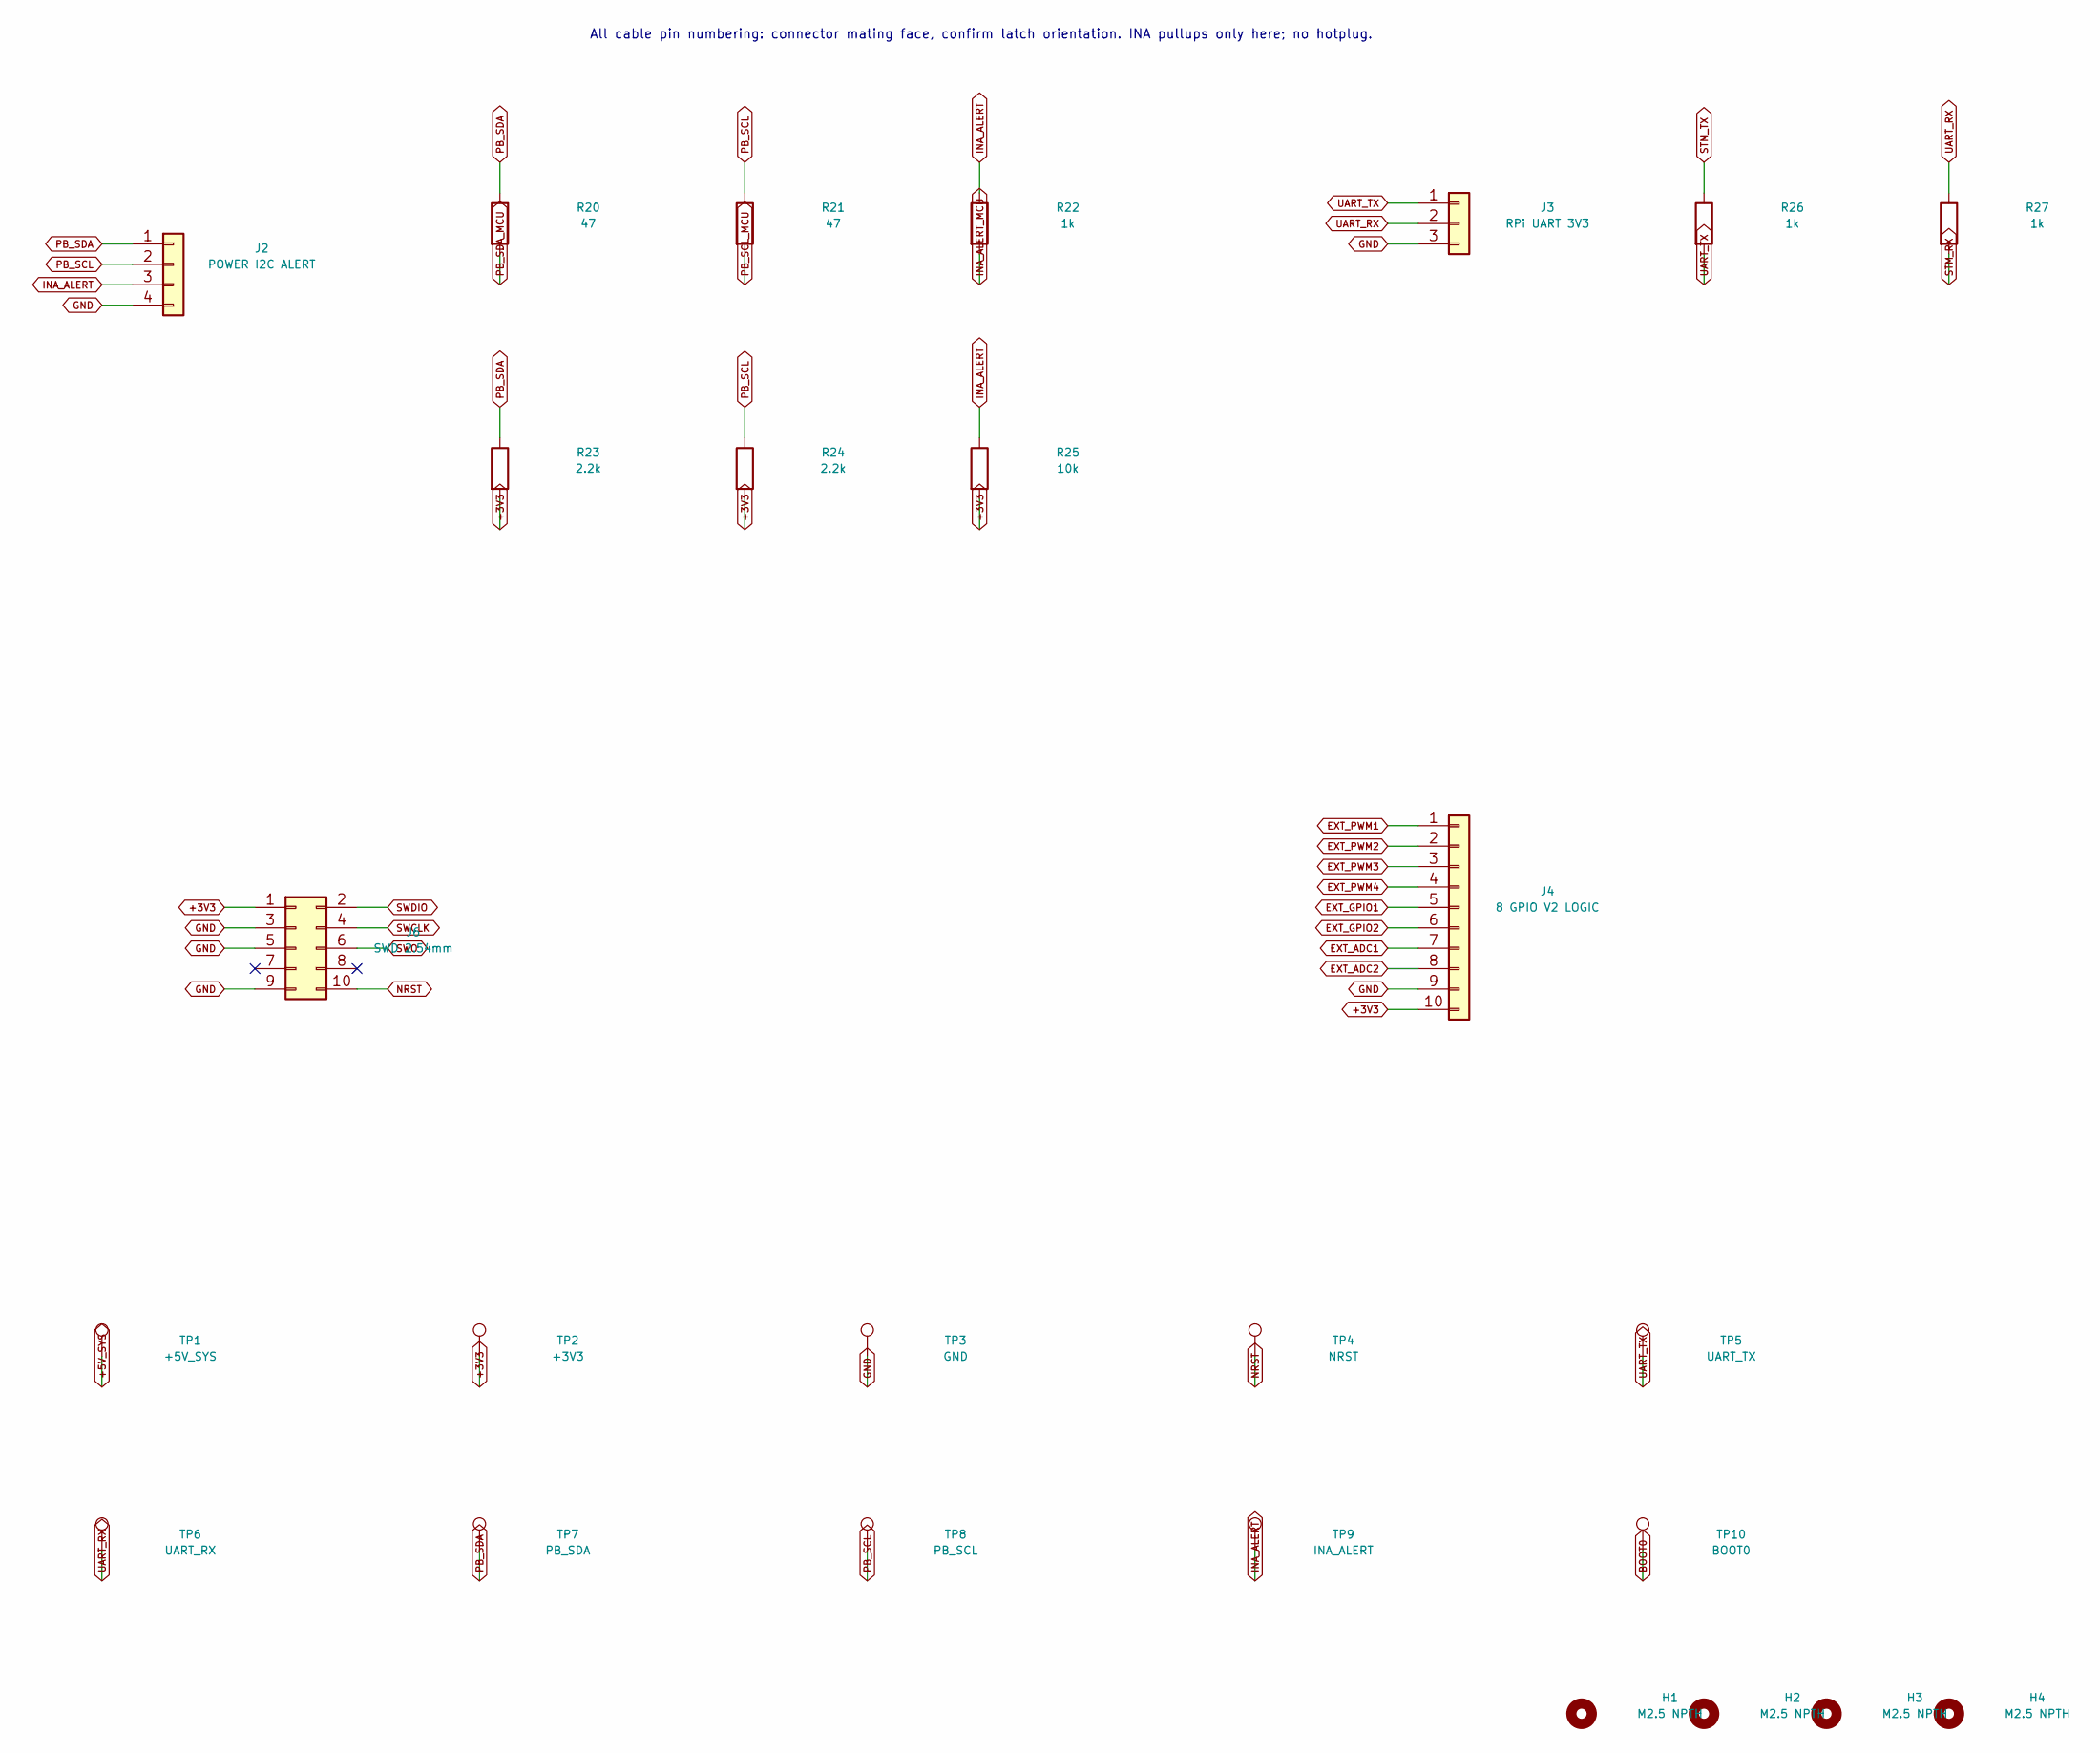
[picture p22: schematic Interfaces.kicad_sch, HYDRA MAIN BOARD V1 — Interfaces]

Parts:
H1, H2, H3, H4: M2.5 NPTH; MountingHole_2.7mm_M2.5
J2: POWER I2C ALERT; Molex_Micro-Latch_53253-0470_1x04_P2.00mm_Vertical; MPN 53253-0470
J3: RPi UART 3V3; Molex_Micro-Latch_53253-0370_1x03_P2.00mm_Vertical; MPN 53253-0370
J4: 8 GPIO V2 LOGIC; Molex_Micro-Latch_53253-1070_1x10_P2.00mm_Vertical; MPN 53253-1070
J6: SWD 2.54mm; PinHeader_2x05_P2.54mm_Vertical; MPN 61301021121
R20, R21: 47; R_0603_1608Metric; MPN RC0603FR-0747RL
R22, R26, R27: 1k; R_0603_1608Metric; MPN RC0603FR-071KL
R23, R24: 2.2k; R_0603_1608Metric; MPN RC0603FR-072K2L
R25: 10k; R_0603_1608Metric; MPN RC0603FR-0710KL
TP1: +5V_SYS; TestPoint_Pad_D1.5mm
TP2: +3V3; TestPoint_Pad_D1.5mm
TP3: GND; TestPoint_Pad_D1.5mm
TP4: NRST; TestPoint_Pad_D1.5mm
TP5: UART_TX; TestPoint_Pad_D1.5mm
TP6: UART_RX; TestPoint_Pad_D1.5mm
TP7: PB_SDA; TestPoint_Pad_D1.5mm
TP8: PB_SCL; TestPoint_Pad_D1.5mm
TP9: INA_ALERT; TestPoint_Pad_D1.5mm
TP10: BOOT0; TestPoint_Pad_D1.5mm

Connections:
+3V3: J4.10, J6.1, R23.2, R24.2, R25.2, TP2.1; also elsewhere on the board
+5V_SYS: TP1.1; also elsewhere on the board
BOOT0: TP10.1; also elsewhere on the board
EXT_ADC1: J4.7; also elsewhere on the board
EXT_ADC2: J4.8; also elsewhere on the board
EXT_GPIO1: J4.5; also elsewhere on the board
EXT_GPIO2: J4.6; also elsewhere on the board
EXT_PWM1: J4.1; also elsewhere on the board
EXT_PWM2: J4.2; also elsewhere on the board
EXT_PWM3: J4.3; also elsewhere on the board
EXT_PWM4: J4.4; also elsewhere on the board
GND: J2.4, J3.3, J4.9, J6.3, J6.5, J6.9, TP3.1; also elsewhere on the board
INA_ALERT: J2.3, R22.1, R25.1, TP9.1
INA_ALERT_MCU: R22.2; also elsewhere on the board
NRST: J6.10, TP4.1; also elsewhere on the board
PB_SCL: J2.2, R21.1, R24.1, TP8.1
PB_SCL_MCU: R21.2; also elsewhere on the board
PB_SDA: J2.1, R20.1, R23.1, TP7.1
PB_SDA_MCU: R20.2; also elsewhere on the board
STM_RX: R27.2; also elsewhere on the board
STM_TX: R26.1; also elsewhere on the board
SWCLK: J6.4; also elsewhere on the board
SWDIO: J6.2; also elsewhere on the board
SWO: J6.6; also elsewhere on the board
UART_RX: J3.2, R27.1, TP6.1
UART_TX: J3.1, R26.2, TP5.1

Notes on the sheet:
All cable pin numbering: connector mating face, confirm latch orientation. INA pullups only here; no hotplug.

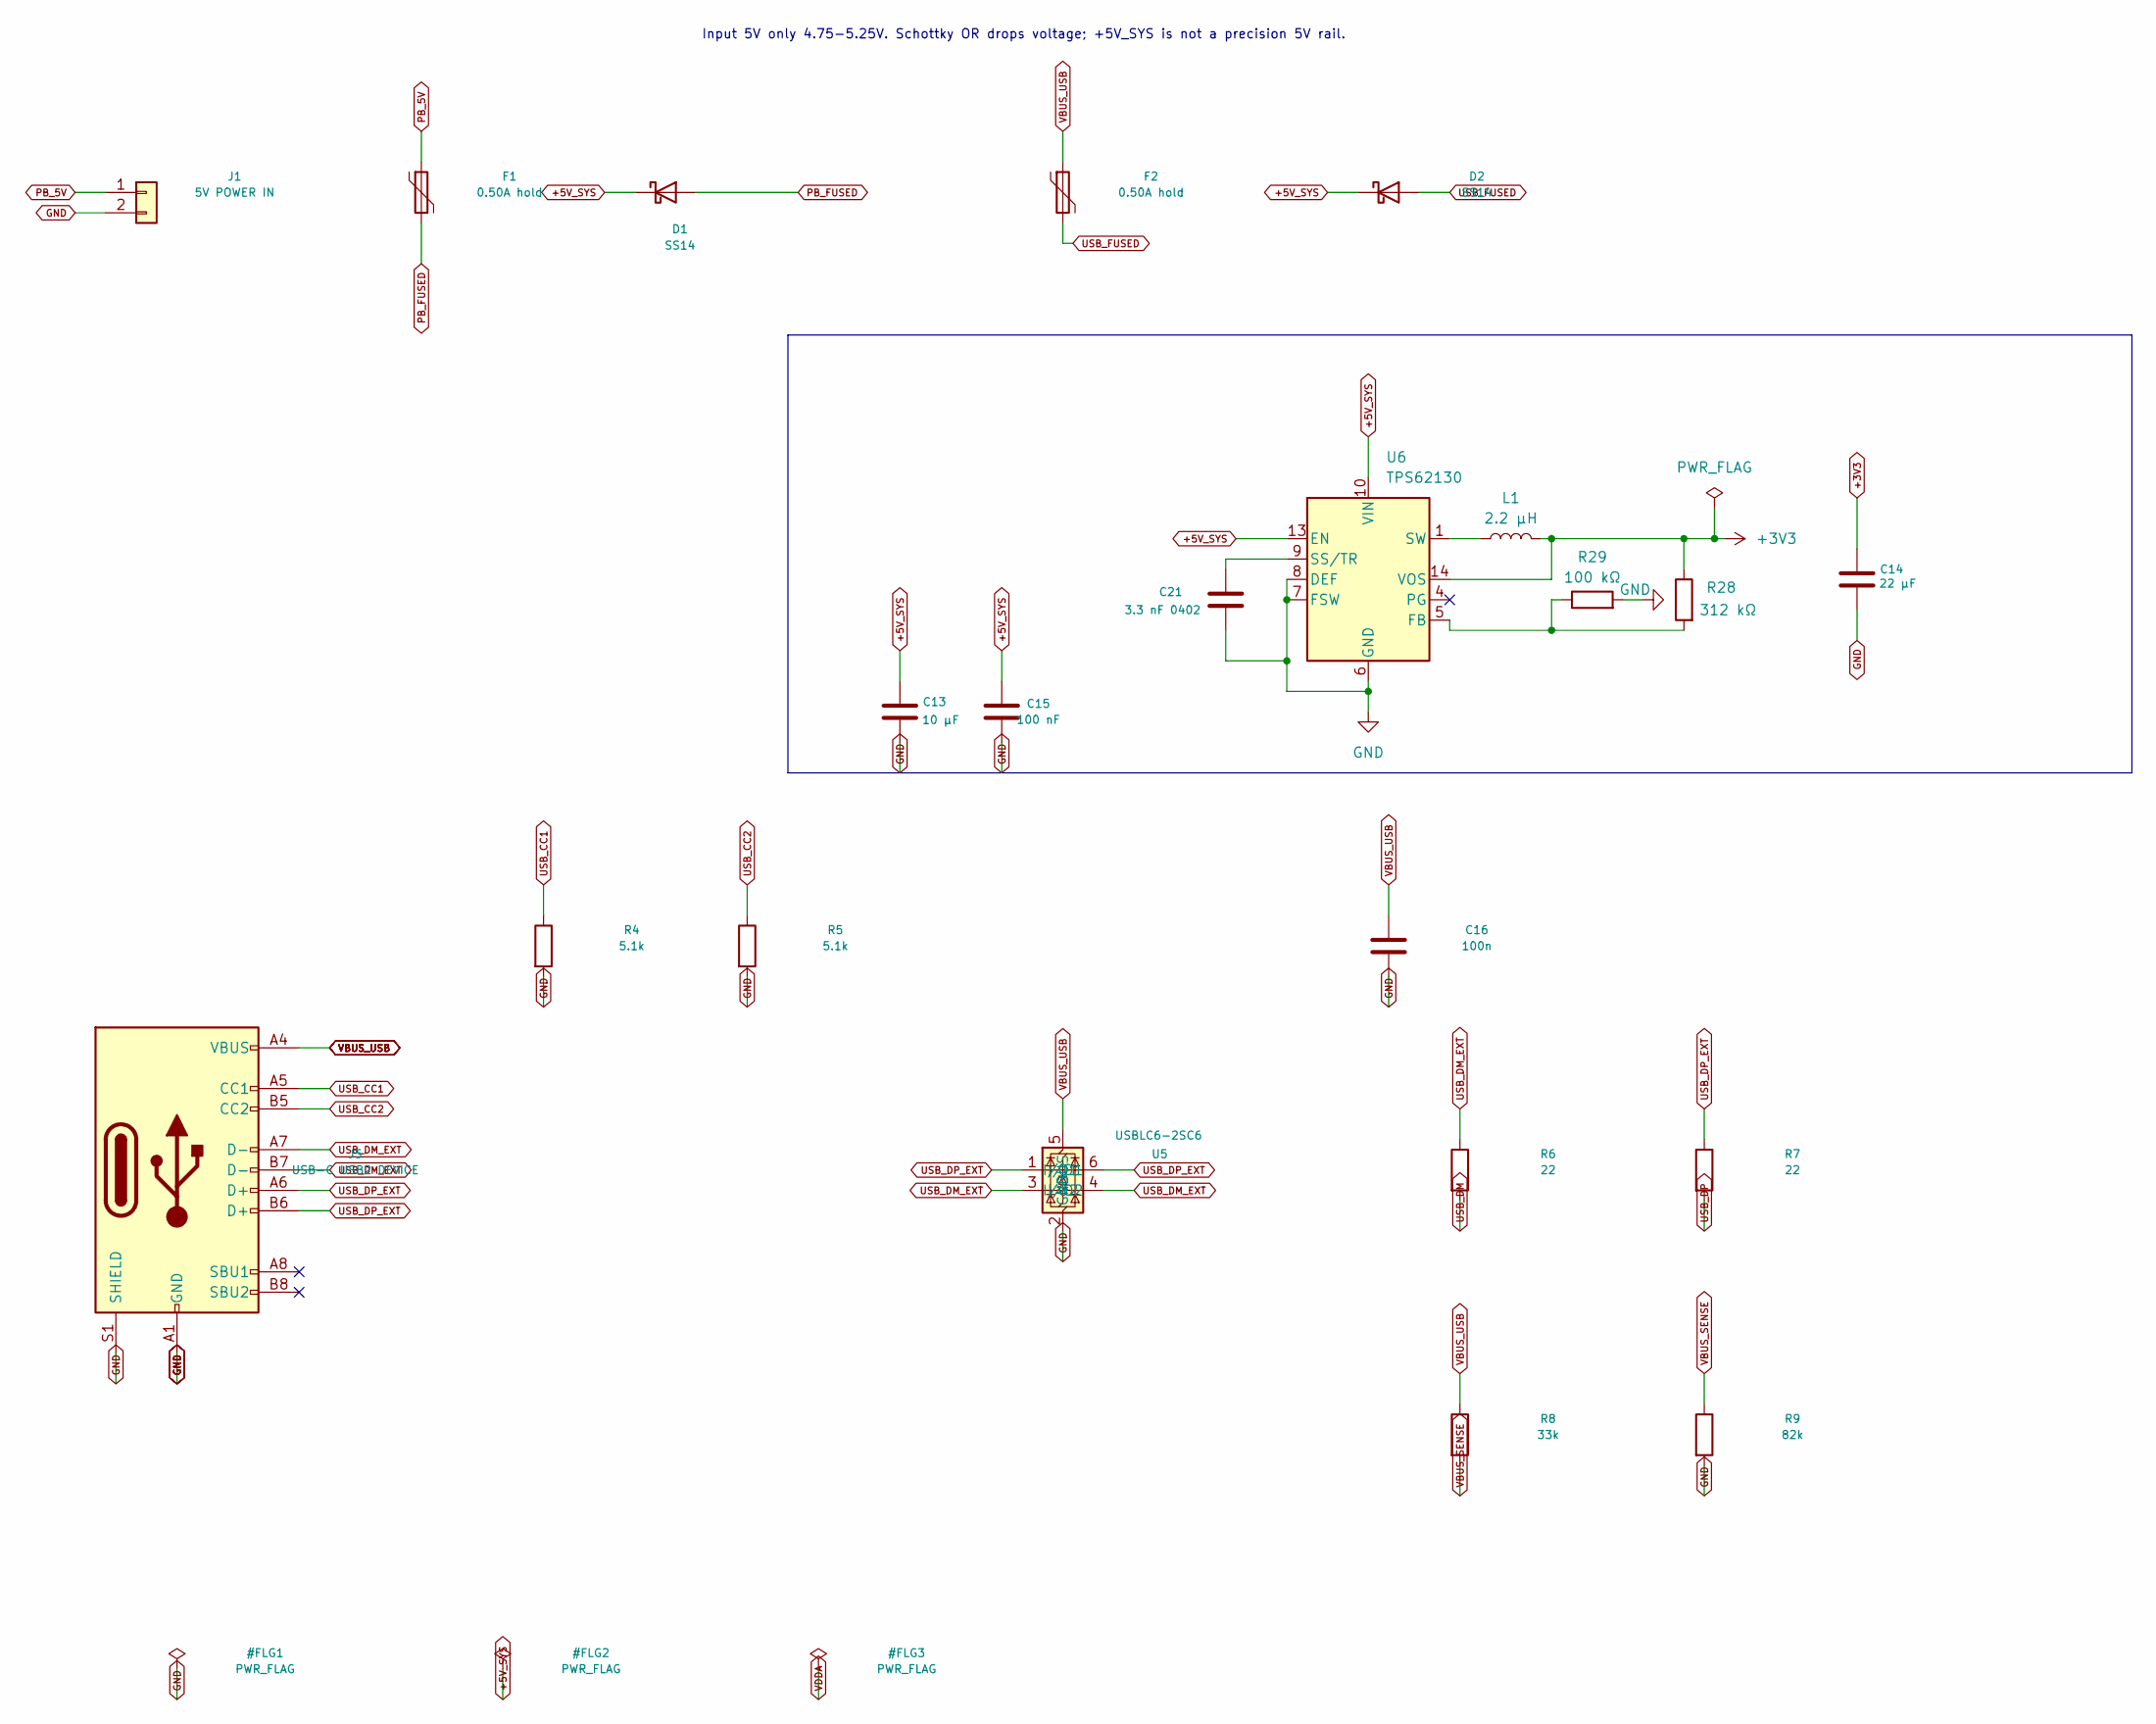
[picture p23: schematic Power_USB.kicad_sch, HYDRA MAIN BOARD V1 — Power_USB]

Parts:
C13: 10 µF; C_0805_2012Metric; MPN GRM21BR71A475KA73L
C14: 22 µF; C_0805_2012Metric; MPN GRM21BR71A475KA73L
C15: 100 nF; C_0603_1608Metric; MPN GRM188R71C104KA01D
C16: 100n; C_0603_1608Metric; MPN GRM188R71C104KA01D
C21: 3.3 nF 0402; C_0603_1608Metric; MPN GRM188R71C104KA01D
D1, D2: SS14; D_SMA; MPN SS14-E3/61T
F1, F2: 0.50A hold; Fuse_1206_3216Metric; MPN 1206L050/15YR
J1: 5V POWER IN; Molex_Micro-Fit_3.0_43650-0221_1x02_P3.00mm_Vertical; MPN 43650-0221
J5: USB-C USB2 DEVICE; USB_C_Receptacle_GCT_USB4105-xx-A_16P_TopMnt_Horizontal; MPN USB4105-GF-A
L1: 2.2 µH
R4, R5: 5.1k; R_0603_1608Metric; MPN RC0603FR-075K1L
R6, R7: 22; R_0603_1608Metric; MPN RC0603FR-0722RL
R8: 33k; R_0603_1608Metric; MPN RC0603FR-0733KL
R9: 82k; R_0603_1608Metric; MPN RC0603FR-0782KL
R28: 312 kΩ
R29: 100 kΩ
U5: USBLC6-2SC6; SOT-23-6; MPN USBLC6-2SC6
U6: TPS62130; VQFN-16-1EP_3x3mm_P0.5mm_EP1.68x1.68mm_ThermalVias

Connections:
+3V3: C14.1; also elsewhere on the board
+5V_SYS: C13.1, C15.1, D1.1 (K), D2.1 (K), U6.10 (VIN), U6.11 (VIN), U6.12 (VIN), U6.13 (EN); also elsewhere on the board
GND: C13.2, C14.2, C15.2, C16.2, J1.2, J5.A1 (GND), J5.A12 (GND), J5.B1 (GND), J5.B12 (GND), J5.S1 (SHIELD), R4.2, R5.2, R9.2, U5.2 (GND); also elsewhere on the board
unnamed: C21.1, U6.9 (SS/TR)
unnamed: C21.2, R29.2, U6.6 (GND), U6.7 (FSW), U6.8 (DEF), U6.15 (GND), U6.16 (GND), U6.17 (GND)
unnamed: L1.1, U6.1 (SW), U6.2 (SW), U6.3 (SW)
unnamed: L1.2, R28.1, U6.14 (VOS)
unnamed: R28.2, R29.1, U6.5 (FB)
PB_5V: F1.1, J1.1
PB_FUSED: D1.2 (A), F1.2
USB_CC1: J5.A5 (CC1), R4.1
USB_CC2: J5.B5 (CC2), R5.1
USB_DM: R6.2; also elsewhere on the board
USB_DM_EXT: J5.A7 (D-), J5.B7 (D-), R6.1, U5.3 (I/O2), U5.4 (I/O2)
USB_DP: R7.2; also elsewhere on the board
USB_DP_EXT: J5.A6 (D+), J5.B6 (D+), R7.1, U5.1 (I/O1), U5.6 (I/O1)
USB_FUSED: D2.2 (A), F2.2
VBUS_SENSE: R8.2, R9.1; also elsewhere on the board
VBUS_USB: C16.1, F2.1, J5.A4 (VBUS), J5.A9 (VBUS), J5.B4 (VBUS), J5.B9 (VBUS), R8.1, U5.5 (VBUS)

Notes on the sheet:
Input 5V only 4.75-5.25V. Schottky OR drops voltage; +5V_SYS is not a precision 5V rail.

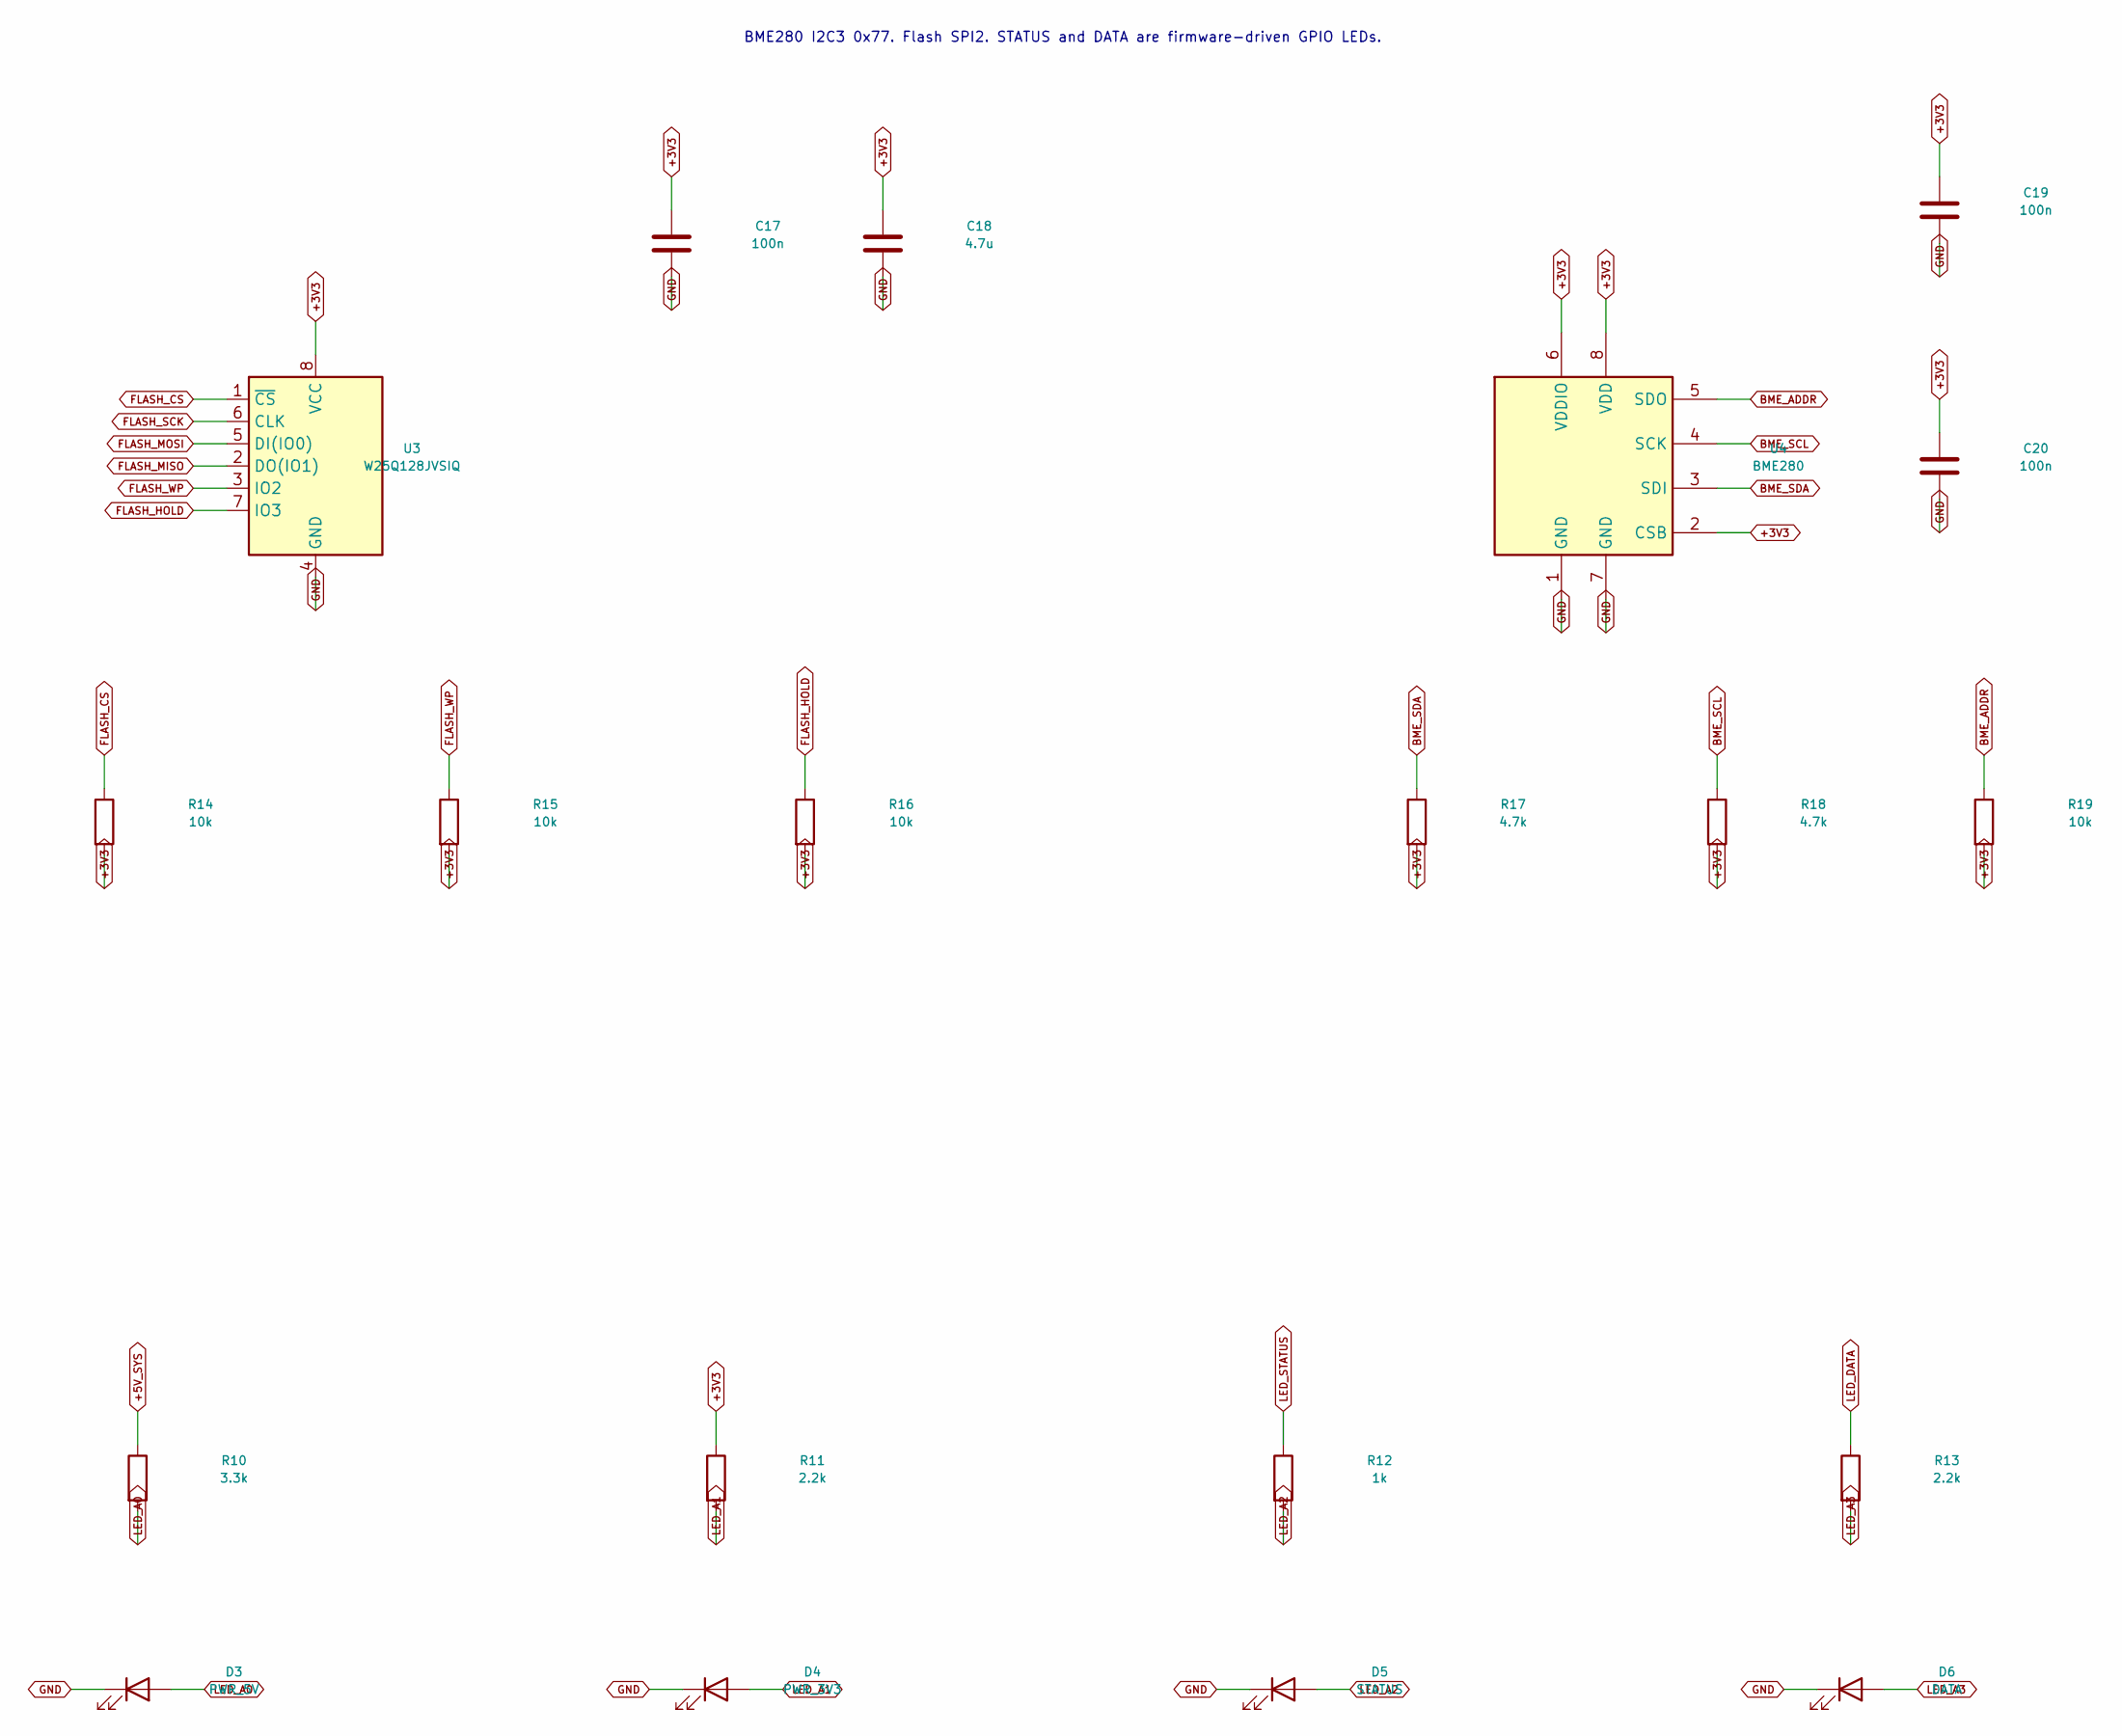
[picture p24: schematic Peripherals.kicad_sch, HYDRA MAIN BOARD V1 — Peripherals]

Parts:
C17, C19, C20: 100n; C_0603_1608Metric; MPN GRM188R71C104KA01D
C18: 4.7u; C_0805_2012Metric; MPN GRM21BR71A475KA73L
D3: PWR_5V; LED_0603_1608Metric; MPN LTST-C190KGKT
D4: PWR_3V3; LED_0603_1608Metric; MPN LTST-C190KGKT
D5: STATUS; LED_0603_1608Metric; MPN LTST-C190TBKT
D6: DATA; LED_0603_1608Metric; MPN LTST-C190KSKT
R10: 3.3k; R_0603_1608Metric; MPN RC0603FR-073K3L
R11, R13: 2.2k; R_0603_1608Metric; MPN RC0603FR-072K2L
R12: 1k; R_0603_1608Metric; MPN RC0603FR-071KL
R14, R15, R16, R19: 10k; R_0603_1608Metric; MPN RC0603FR-0710KL
R17, R18: 4.7k; R_0603_1608Metric; MPN RC0603FR-074K7L
U3: W25Q128JVSIQ; SOIC-8_5.23x5.23mm_P1.27mm; MPN W25Q128JVSIQ
U4: BME280; Bosch_LGA-8_2.5x2.5mm_P0.65mm_ClockwisePinNumbering; MPN BME280

Connections:
+3V3: C17.1, C18.1, C19.1, C20.1, R11.1, R14.2, R15.2, R16.2, R17.2, R18.2, R19.2, U3.8 (VCC), U4.2 (CSB), U4.6 (VDDIO), U4.8 (VDD); also elsewhere on the board
+5V_SYS: R10.1; also elsewhere on the board
BME_ADDR: R19.1, U4.5 (SDO)
BME_SCL: R18.1, U4.4 (SCK); also elsewhere on the board
BME_SDA: R17.1, U4.3 (SDI); also elsewhere on the board
FLASH_CS: R14.1, U3.1 (~CS); also elsewhere on the board
FLASH_HOLD: R16.1, U3.7 (IO3)
FLASH_MISO: U3.2 (DO(IO1)); also elsewhere on the board
FLASH_MOSI: U3.5 (DI(IO0)); also elsewhere on the board
FLASH_SCK: U3.6 (CLK); also elsewhere on the board
FLASH_WP: R15.1, U3.3 (IO2)
GND: C17.2, C18.2, C19.2, C20.2, D3.1 (K), D4.1 (K), D5.1 (K), D6.1 (K), U3.4 (GND), U4.1 (GND), U4.7 (GND); also elsewhere on the board
LED_A0: D3.2 (A), R10.2
LED_A1: D4.2 (A), R11.2
LED_A2: D5.2 (A), R12.2
LED_A3: D6.2 (A), R13.2
LED_DATA: R13.1; also elsewhere on the board
LED_STATUS: R12.1; also elsewhere on the board

Notes on the sheet:
BME280 I2C3 0x77. Flash SPI2. STATUS and DATA are firmware-driven GPIO LEDs.

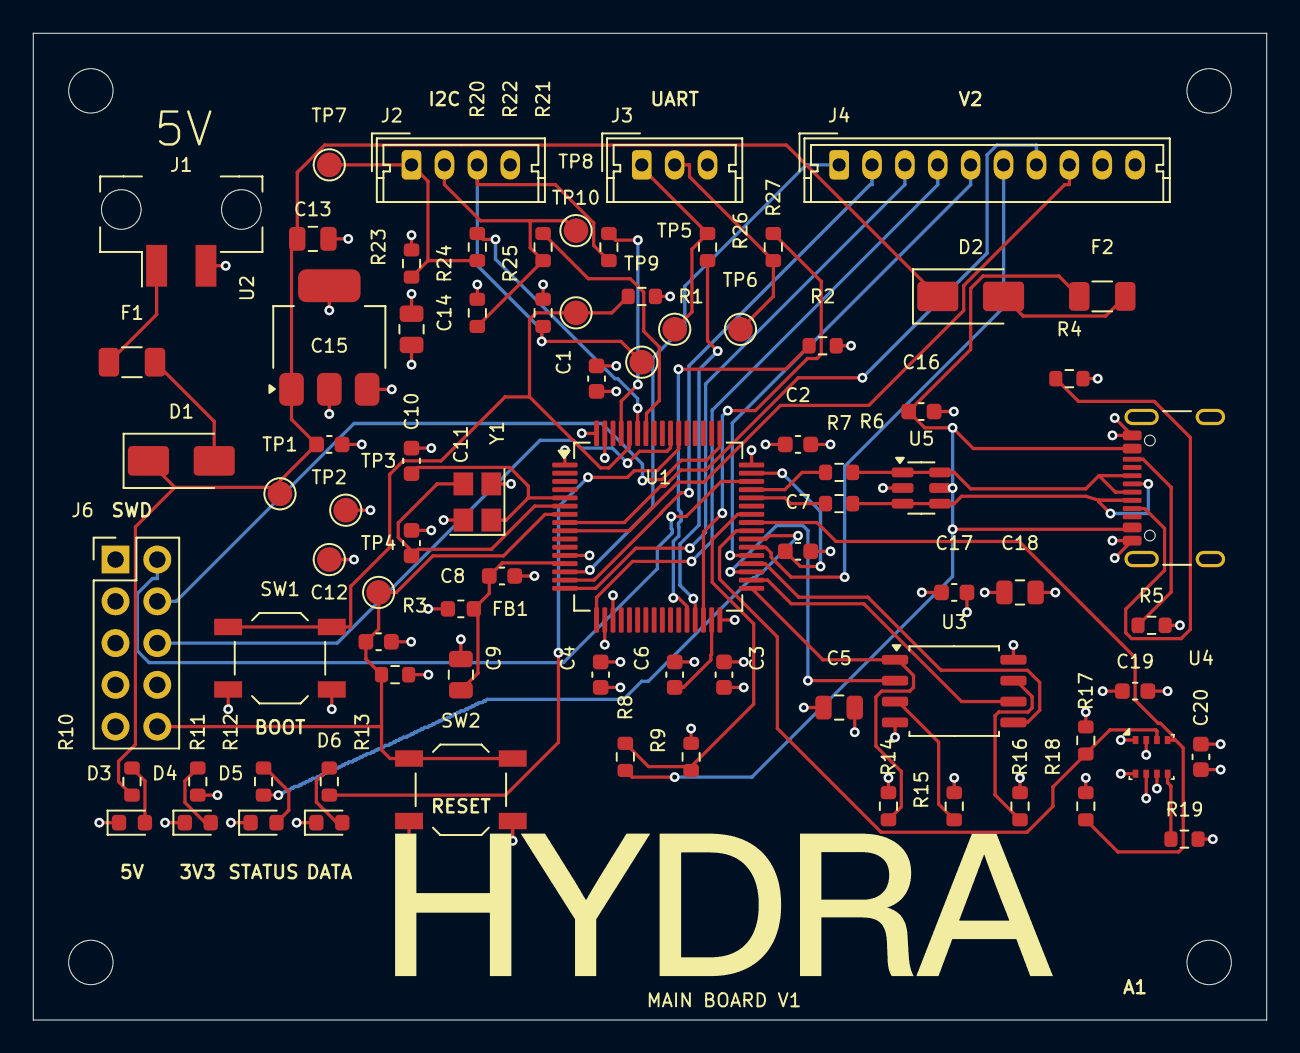
[picture p25: board HYDRA_MAIN_V1.kicad_pcb from above]

Board: 4 copper layers, 75.0 x 60.0 mm, 85 parts (0 on the bottom side), 58 nets.

Other parts of the board:
LOGO1: HYDRA_Official_Wordmark_40mm
U2: AP7361C-33E-13; SOT-223-3_TabPin2

Their connections:
+3V3: U2.3; also elsewhere on the board
+5V_SYS: U2.1; also elsewhere on the board
GND: U2.2; also elsewhere on the board
