GingaShift/hydra-electronics/Elec_Hydra/Main_Board/Elec_Hydra/Capteurs.kicad_sch

## KiCad design Elec_Hydra/Main_Board/Elec_Hydra/Capteurs.kicad_sch (2026-11-01)

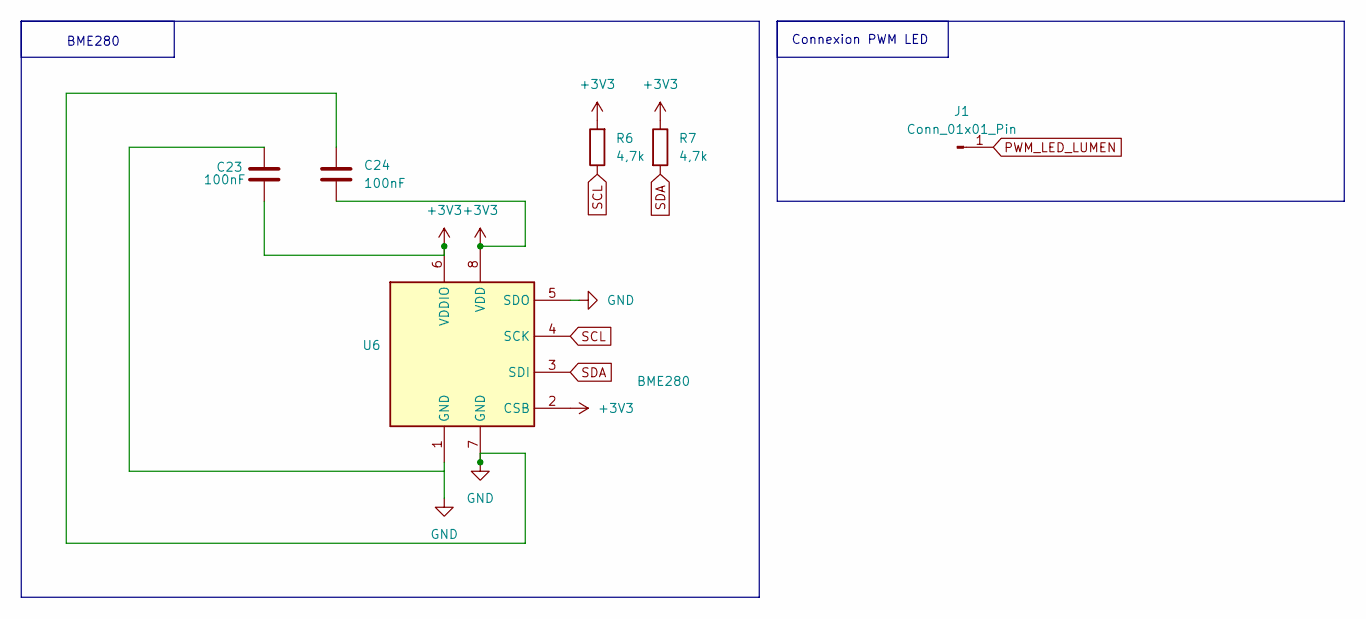
[picture p26: schematic Capteurs.kicad_sch]

Parts:
C23: 100nF
C24: 100nF; Bosch_LGA-8_2.5x2.5mm_P0.65mm_ClockwisePinNumbering
J1: Conn_01x01_Pin
R6: 4,7k
R7: 4,7k; Bosch_LGA-8_3x3mm_P0.8mm_ClockwisePinNumbering
U6: BME280; Bosch_LGA-8_2.5x2.5mm_P0.65mm_ClockwisePinNumbering

Connections:
+3V3: C23.2, C24.2, R6.2, R7.1, U6.2 (CSB), U6.6 (VDDIO), U6.8 (VDD)
GND: C24.1, U6.1 (GND), U6.5 (SDO), U6.7 (GND)
PWM_LED_LUMEN: J1.1
SCL: R6.1, U6.4 (SCK)
SDA: R7.2, U6.3 (SDI)

Notes on the sheet:
Connexion PWM LED
BME280
