GingaShift/hydra-electronics/Elec_Hydra/Main_Board/Elec_Hydra/Elec_Hydra.kicad_sch

## KiCad design Elec_Hydra/Main_Board/Elec_Hydra/Elec_Hydra.kicad_sch (2026-10-06)

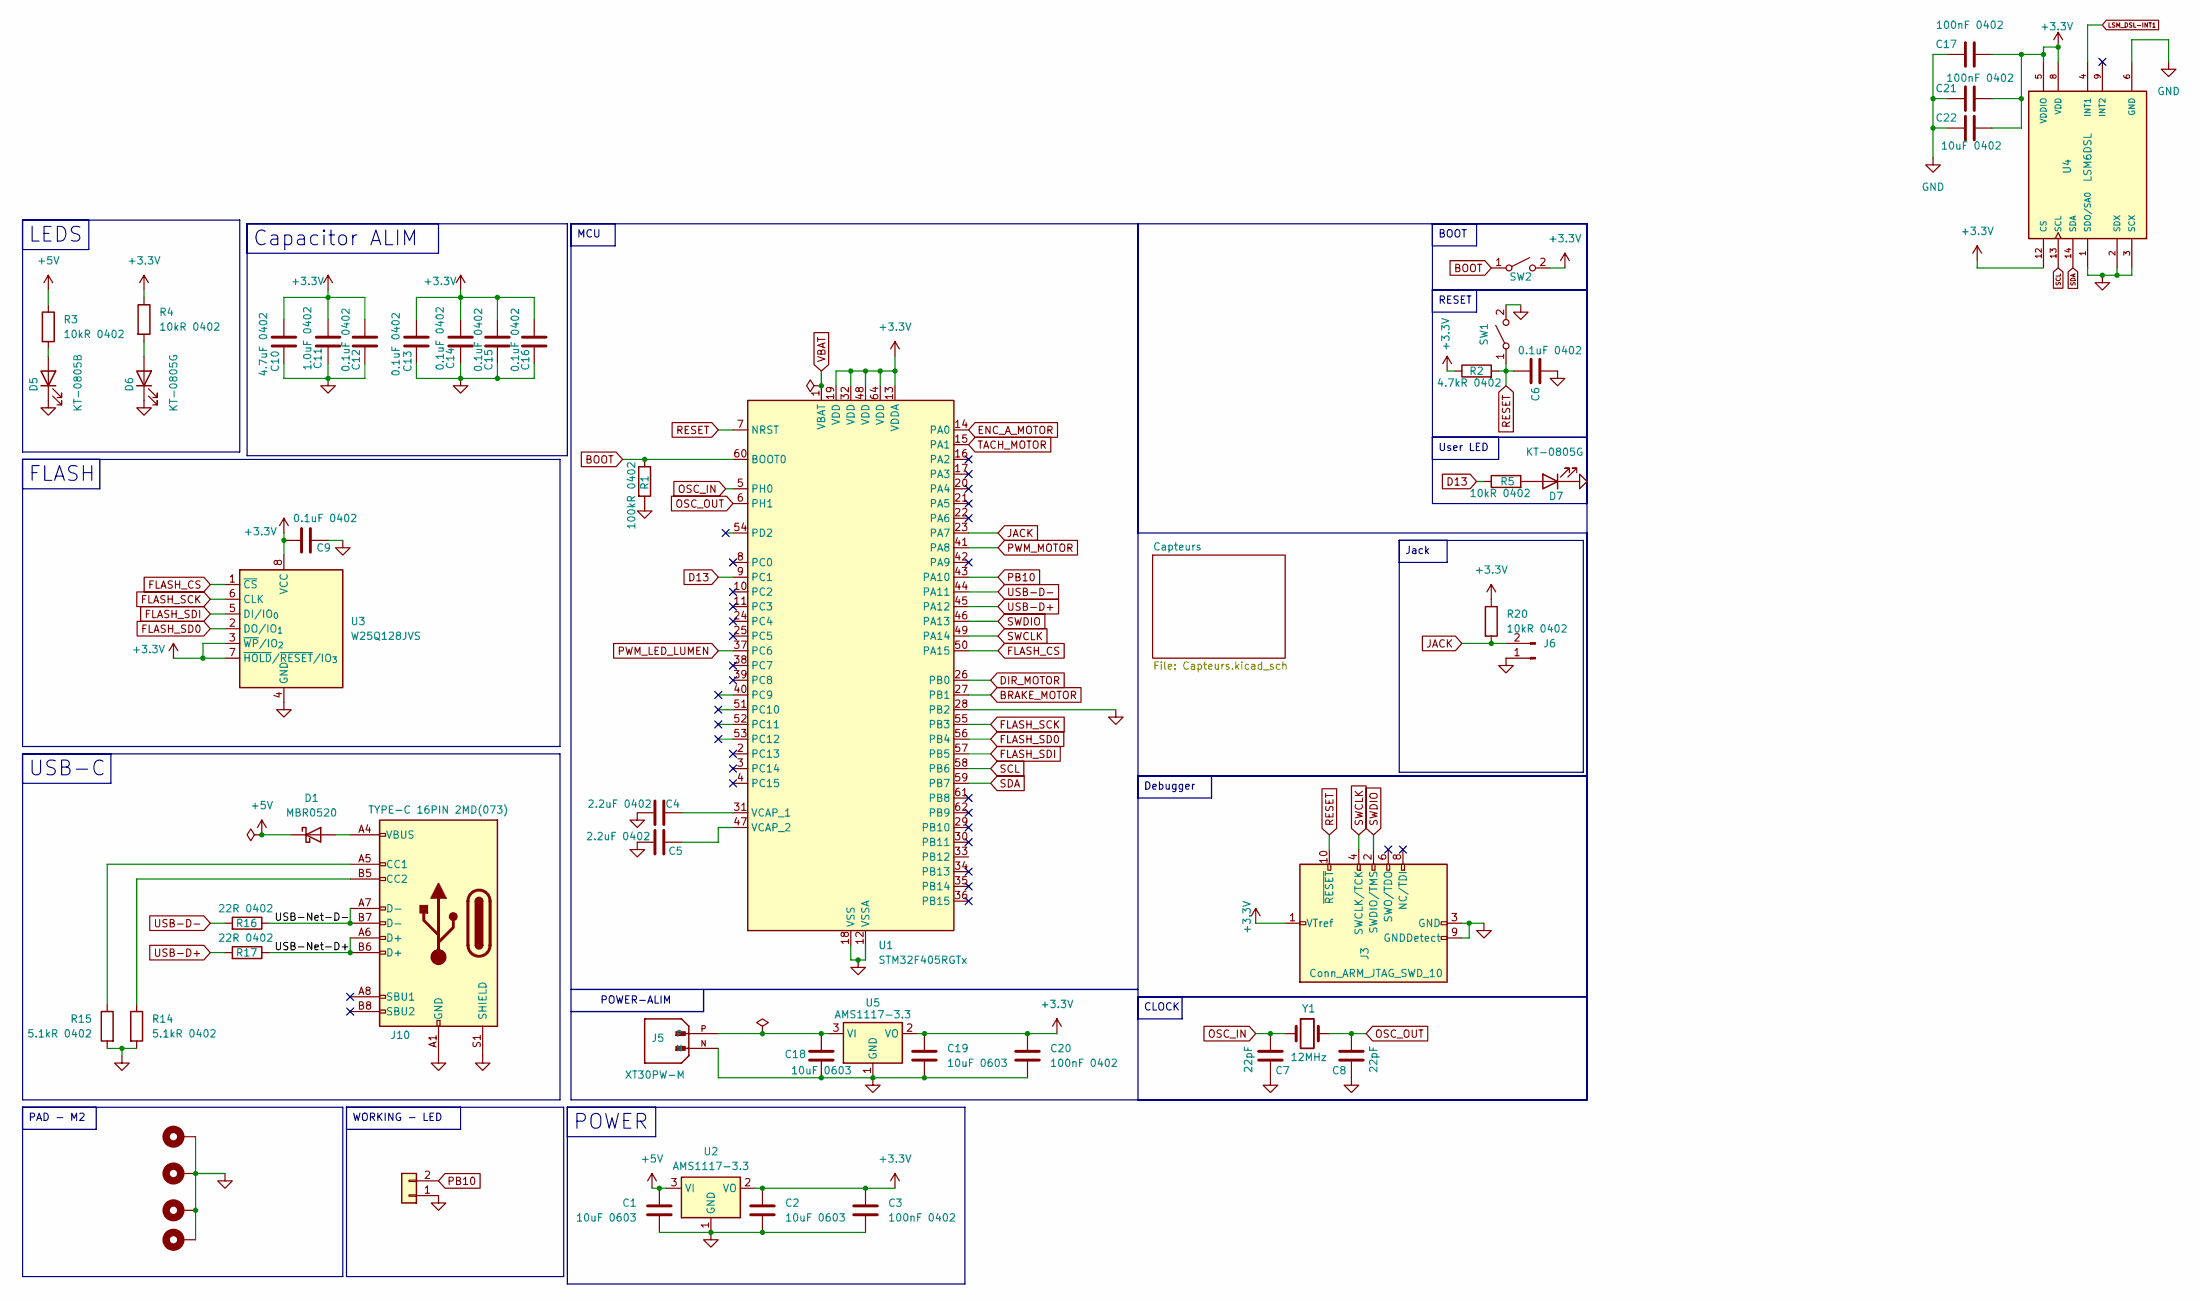
[picture p27: schematic Elec_Hydra.kicad_sch]

Parts:
C1, C2, C18, C19: 10uF 0603; C_0603_1608Metric
C3, C17, C20, C21: 100nF 0402; C_0402_1005Metric
C4, C5: 2.2uF 0402; C_0402_1005Metric
C6, C9, C12, C13, C14, C15, C16: 0.1uF 0402; C_0402_1005Metric
C7, C8: 22pF; C_0402_1005Metric
C10: 4.7uF 0402; C_0402_1005Metric
C11: 1.0uF 0402; C_0402_1005Metric
C22: 10uF 0402; C_0402_1005Metric
D1: MBR0520; D_SOD-123
D5: KT-0805B; LED_0805_2012Metric
D6, D7: KT-0805G; LED_0805_2012Metric
H1, H2, H3, H4: MountingHole_Pad; MountingHole_2.2mm_M2_DIN965_Pad
J2: Conn_01x02; JST_XH_S2B-XH-A_1x02_P2.50mm_Horizontal
J3: Conn_ARM_JTAG_SWD_10; PinHeader_2x05_P2.54mm_Vertical
J5: XT30PW-M; AMASS_XT30PW-M; PARTREV 1.2
J6: Conn_01x02_Pin; JST_XH_S2B-XH-A_1x02_P2.50mm_Horizontal
J10: TYPE-C 16PIN 2MD(073); USB_C_Receptacle_GCT_USB4105-xx-A_16P_TopMnt_Horizontal
R1: 100kR 0402; R_0402_1005Metric
R2: 4.7kR 0402; R_0402_1005Metric
R3, R4, R5, R20: 10kR 0402; R_0402_1005Metric
R14, R15: 5.1kR 0402; R_0402_1005Metric
R16, R17: 22R 0402; R_0402_1005Metric
SW1, SW2: SW_SPST; SW_Tactile_SPST_NO_Straight_CK_PTS636Sx25SMTRLFS
U1: STM32F405RGTx; LQFP-64_10x10mm_P0.5mm
U2, U5: AMS1117-3.3; SOT-223-3_TabPin2
U3: W25Q128JVS; SOIC-8_5.3x5.3mm_P1.27mm
U4: LSM6DSL; PQFN50P300X250X86-14N; PARTREV 7
Y1: 12MHz; Crystal_SMD_5032-2Pin_5.0x3.2mm

Connections:
OSC_IN: C7.1, U1.5 (PH0), Y1.1
OSC_OUT: C8.1, U1.6 (PH1), Y1.2
+3.3V: C2.1, C3.1, C9.1, C10.1, C11.1, C12.1, C13.1, C14.1, C15.1, C16.1, C17.2, C19.1, C20.1, C21.2, C22.2, J3.1 (VTref), R2.1, R4.1, R20.1, SW2.2 (B), U1.13 (VDDA), U1.19 (VDD), U1.32 (VDD), U1.48 (VDD), U1.64 (VDD), U2.2 (VO), U3.3 (~WP/IO_{2}), U3.7 (~HOLD/~RESET/IO_{3}), U3.8 (VCC), U4.5 (VDDIO), U4.8 (VDD), U4.12 (CS), U5.2 (VO)
+5V: C1.1, D1.1 (K), R3.1, U2.3 (VI)
BOOT: R1.1, SW2.1 (A), U1.60 (BOOT0)
BRAKE_MOTOR: U1.27 (PB1)
D13: R5.1, U1.9 (PC1)
DIR_MOTOR: U1.26 (PB0)
ENC_A_MOTOR: U1.14 (PA0)
FLASH_CS: U1.50 (PA15), U3.1 (~CS)
FLASH_SCK: U1.55 (PB3), U3.6 (CLK)
FLASH_SD0: U1.56 (PB4), U3.2 (DO/IO_{1})
FLASH_SDI: U1.57 (PB5), U3.5 (DI/IO_{0})
GND: C1.2, C2.2, C3.2, C4.1, C5.1, C6.2, C7.2, C8.2, C9.2, C10.2, C11.2, C12.2, C13.2, C14.2, C15.2, C16.2, C17.1, C18.2, C19.2, C20.2, C21.1, C22.1, D5.1 (K), D6.1 (K), D7.1 (K), H1.1, H2.1, H3.1, H4.1, J2.1, J3.3 (GND), J3.5 (GND), J3.9 (GNDDetect), J5.N, J6.1, J10.A1 (GND), J10.A12 (GND), J10.B1 (GND), J10.B12 (GND), J10.S1 (SHIELD), R1.2, R14.2, R15.2, SW1.2 (B), U1.12 (VSSA), U1.18 (VSS), U1.28 (PB2), U1.63 (VSS), U2.1 (GND), U3.4 (GND), U4.1 (SDO/SA0), U4.2 (SDX), U4.3 (SCX), U4.6 (GND), U4.7 (GND), U5.1 (GND)
JACK: J6.2, R20.2, U1.23 (PA7)
LSM_DSL-INT1: U4.4 (INT1)
unnamed: C4.2, U1.31 (VCAP_1)
unnamed: C5.2, U1.47 (VCAP_2)
unnamed: C18.1, J5.P, U5.3 (VI)
unnamed: D1.2 (A), J10.A4 (VBUS), J10.A9 (VBUS), J10.B4 (VBUS), J10.B9 (VBUS)
unnamed: D5.2 (A), R3.2
unnamed: D6.2 (A), R4.2
unnamed: D7.2 (A), R5.2
unnamed: J10.A5 (CC1), R15.1
unnamed: J10.B5 (CC2), R14.1
PB10: J2.2, U1.43 (PA10)
PWM_LED_LUMEN: U1.37 (PC6)
PWM_MOTOR: U1.41 (PA8)
RESET: C6.1, J3.10 (~RESET), R2.2, SW1.1 (A), U1.7 (NRST)
SCL: U1.58 (PB6), U4.13 (SCL)
SDA: U1.59 (PB7), U4.14 (SDA)
SWCLK: J3.4 (SWCLK/TCK), U1.49 (PA14)
SWDIO: J3.2 (SWDIO/TMS), U1.46 (PA13)
TACH_MOTOR: U1.15 (PA1)
USB-D+: R17.2, U1.45 (PA12)
USB-D-: R16.2, U1.44 (PA11)
USB-Net-D+: J10.A6 (D+), J10.B6 (D+), R17.1
USB-Net-D-: J10.A7 (D-), J10.B7 (D-), R16.1
VBAT: U1.1 (VBAT)

Notes on the sheet:
POWER-ALIM
LEDS
BOOT
User LED
CLOCK
FLASH
RESET
Capacitor ALIM
POWER
MCU
USB-C
Jack
PAD - M2
Debugger
WORKING - LED
