GingaShift/hydra-electronics/(commit log)

2026-10-06 First commit
    Kicad Files Main board
2026-11-01 V1 main board
